flisboac/mixpower-path-mini-bq25672-lv-board/kicad/projects/mixpower-path-mini-bq25672-lv-board-r1/plot/mixpower-path-mini-bq25672-lv-board-r1.pdf

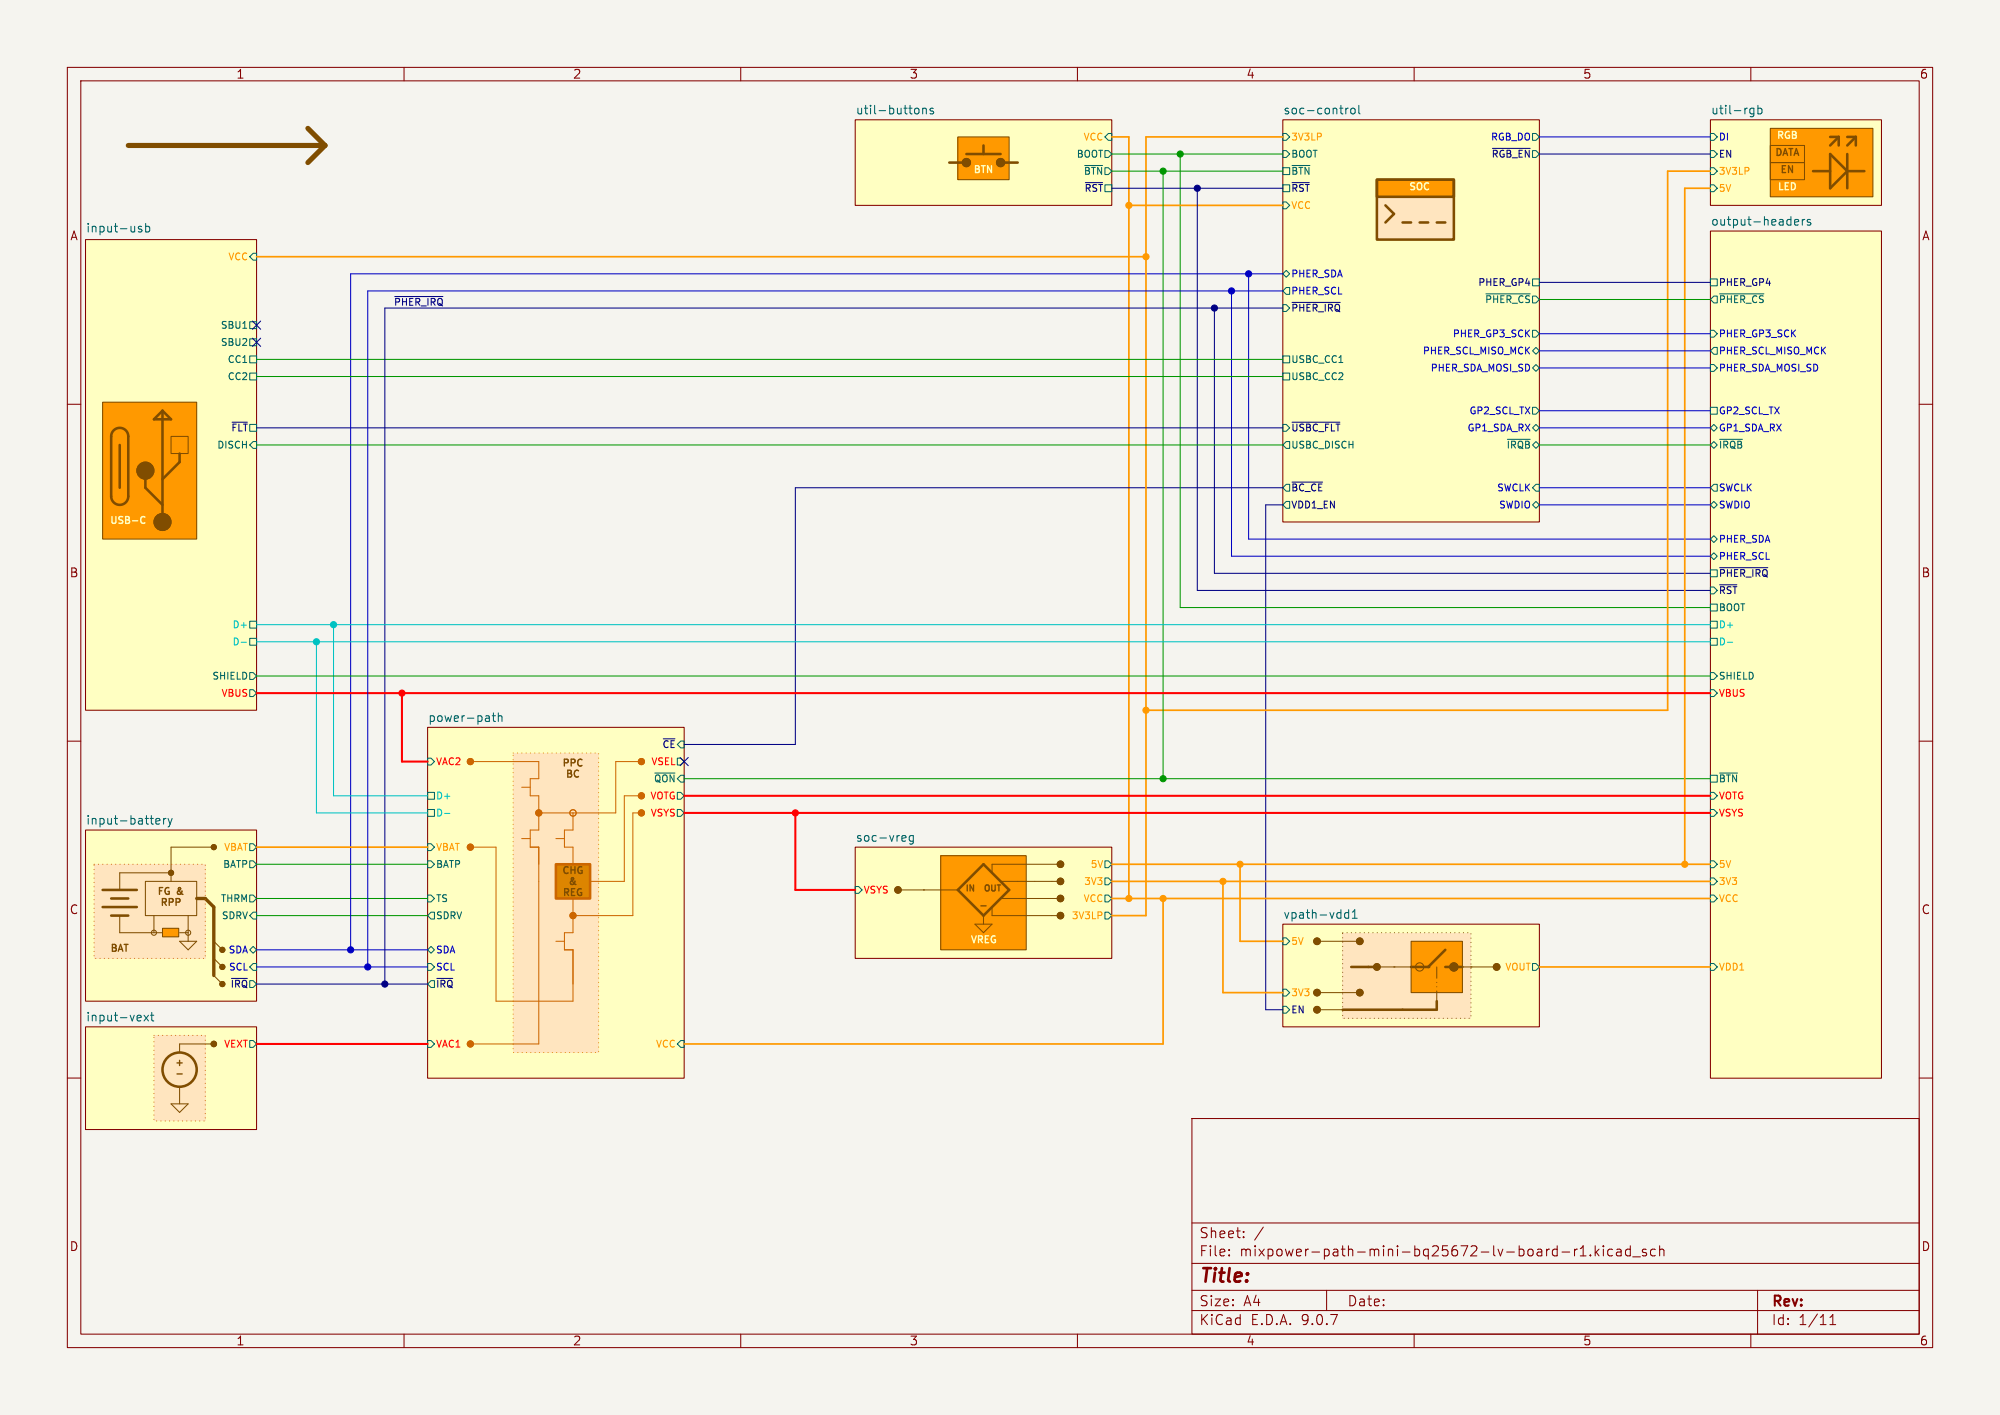
[picture p14: page 1]

~{RST} BOOT util-buttons

Id: 1/11 Title: File: mixpower-path-mini-bq25672-lv-board-r1.kicad_sch Sheet: /

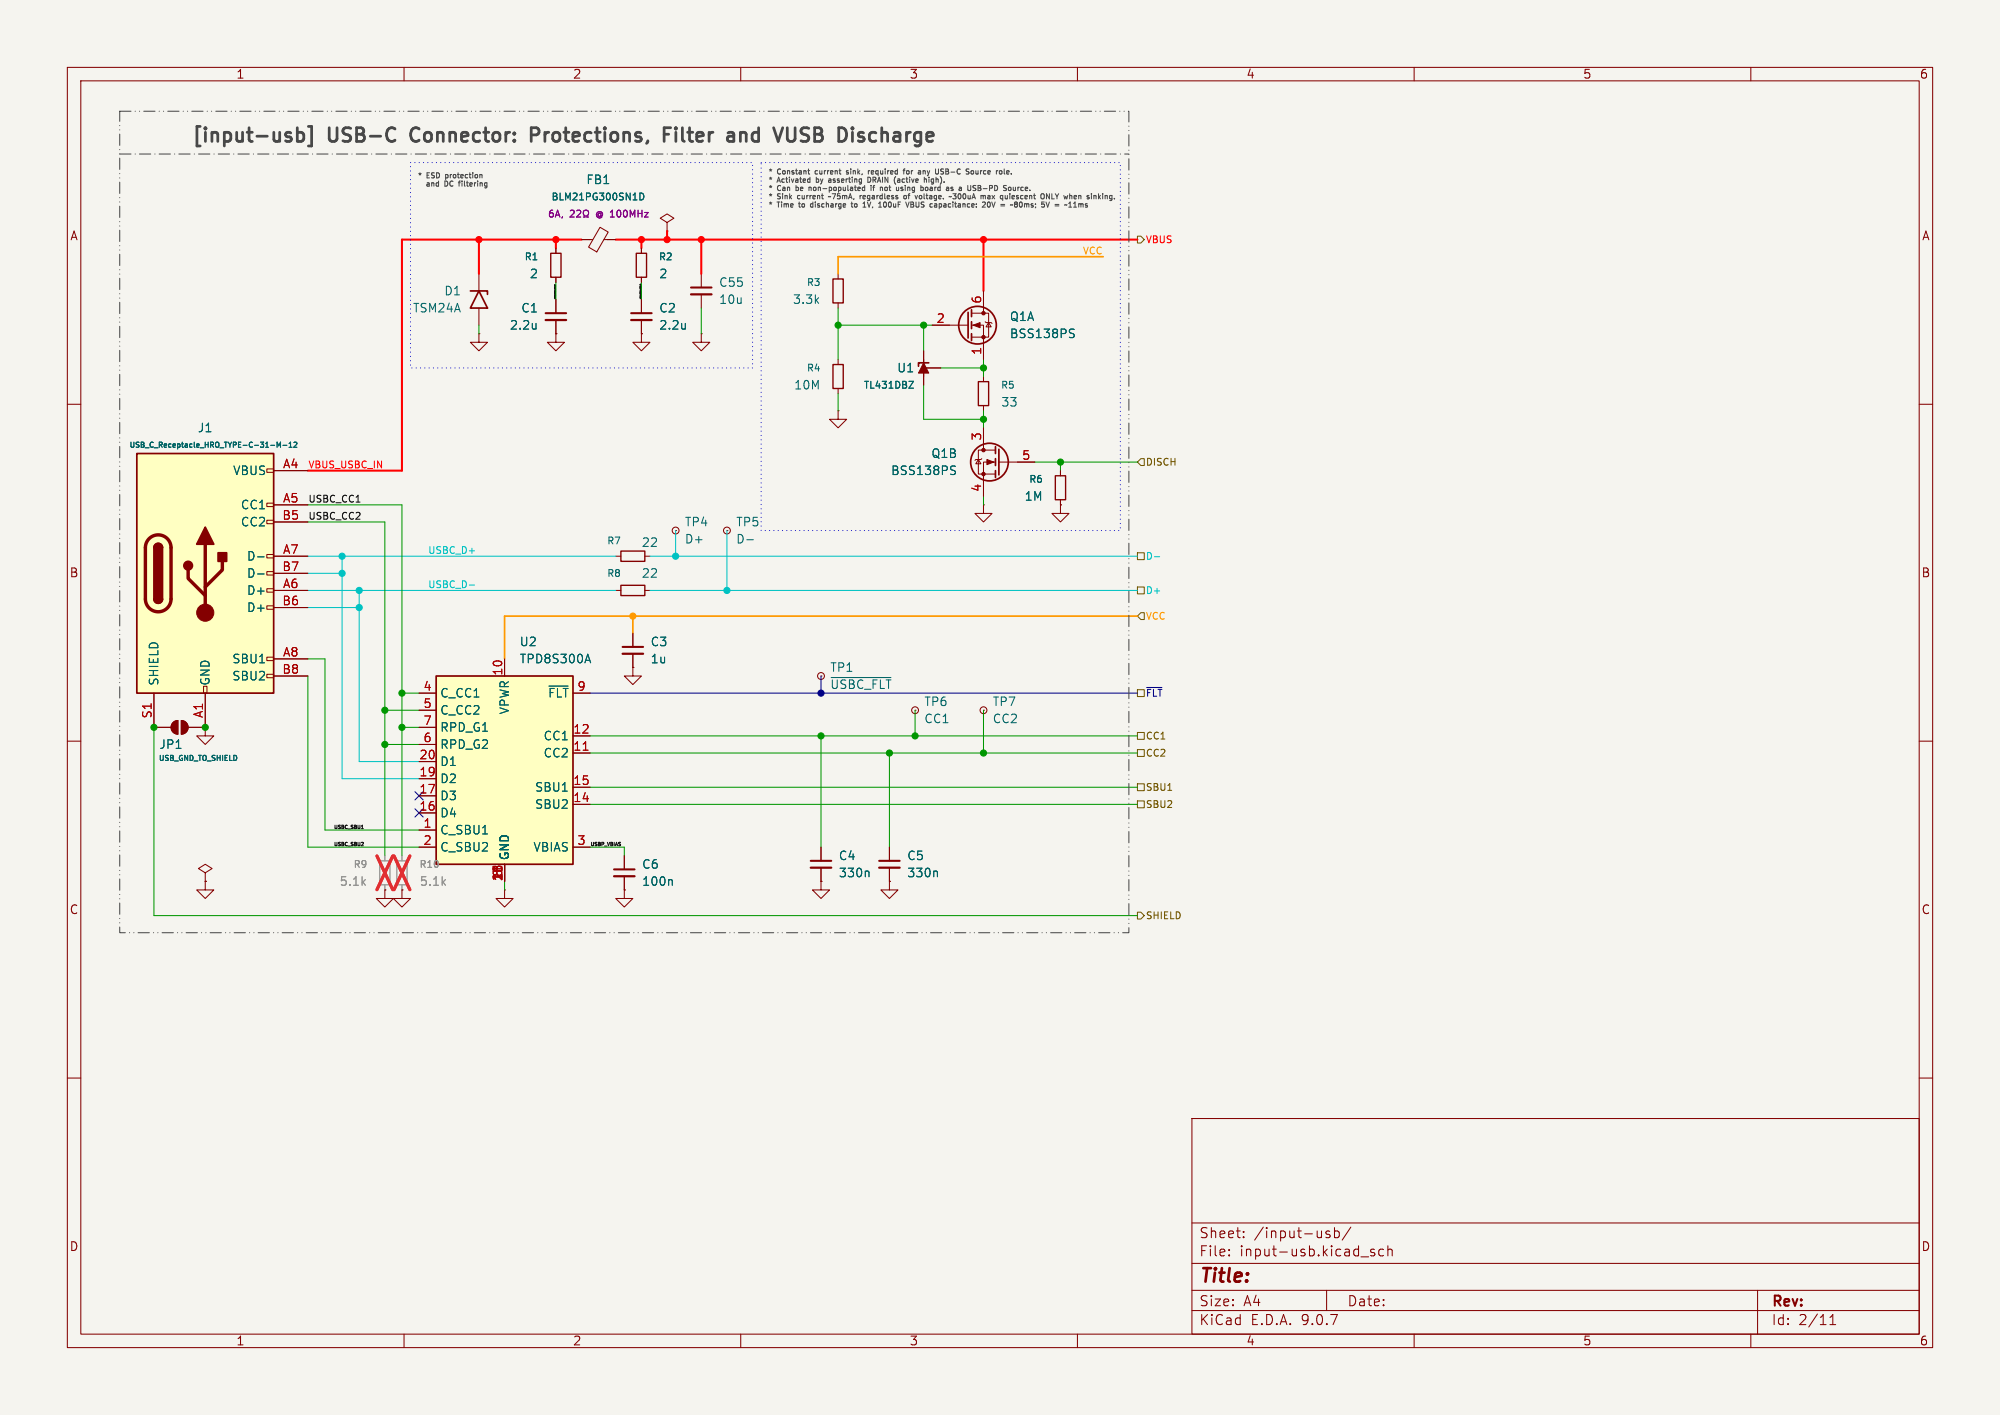
[picture p15: page 2]

Id: 2/11 Title: File: input-usb.kicad_sch Sheet: /input-usb/

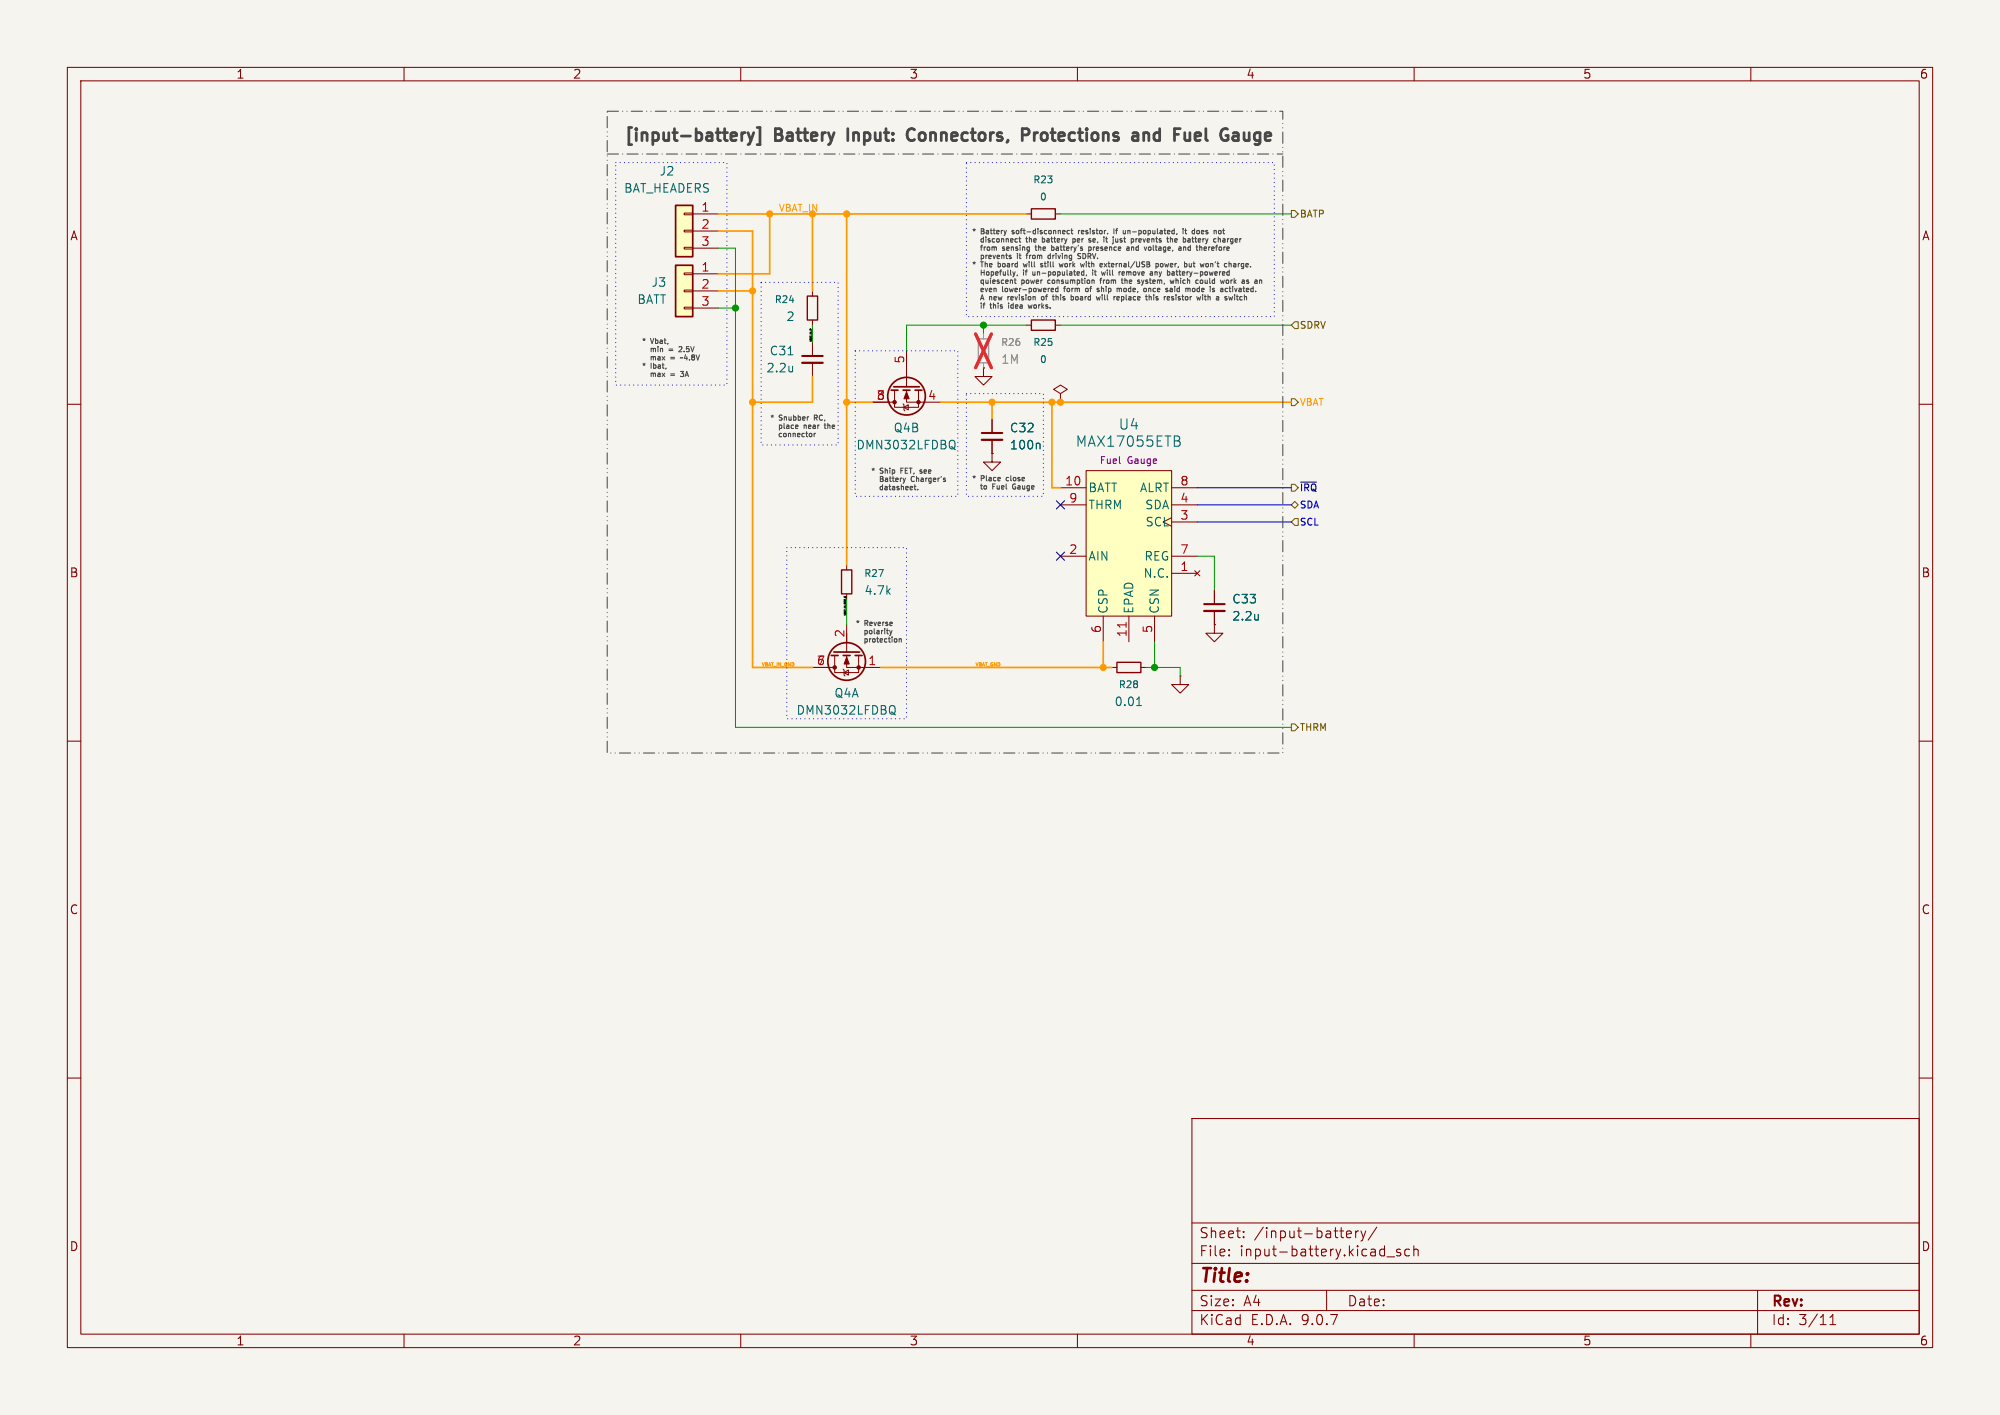
[picture p16: page 3]

* Snubber RC, place near the

5 ALRT 8 SDA 4 SCL 3 REG 7 N.C. 1 U4 MAX17055ETB

Id: 3/11 Title: File: input-battery.kicad_sch Sheet: /input-battery/

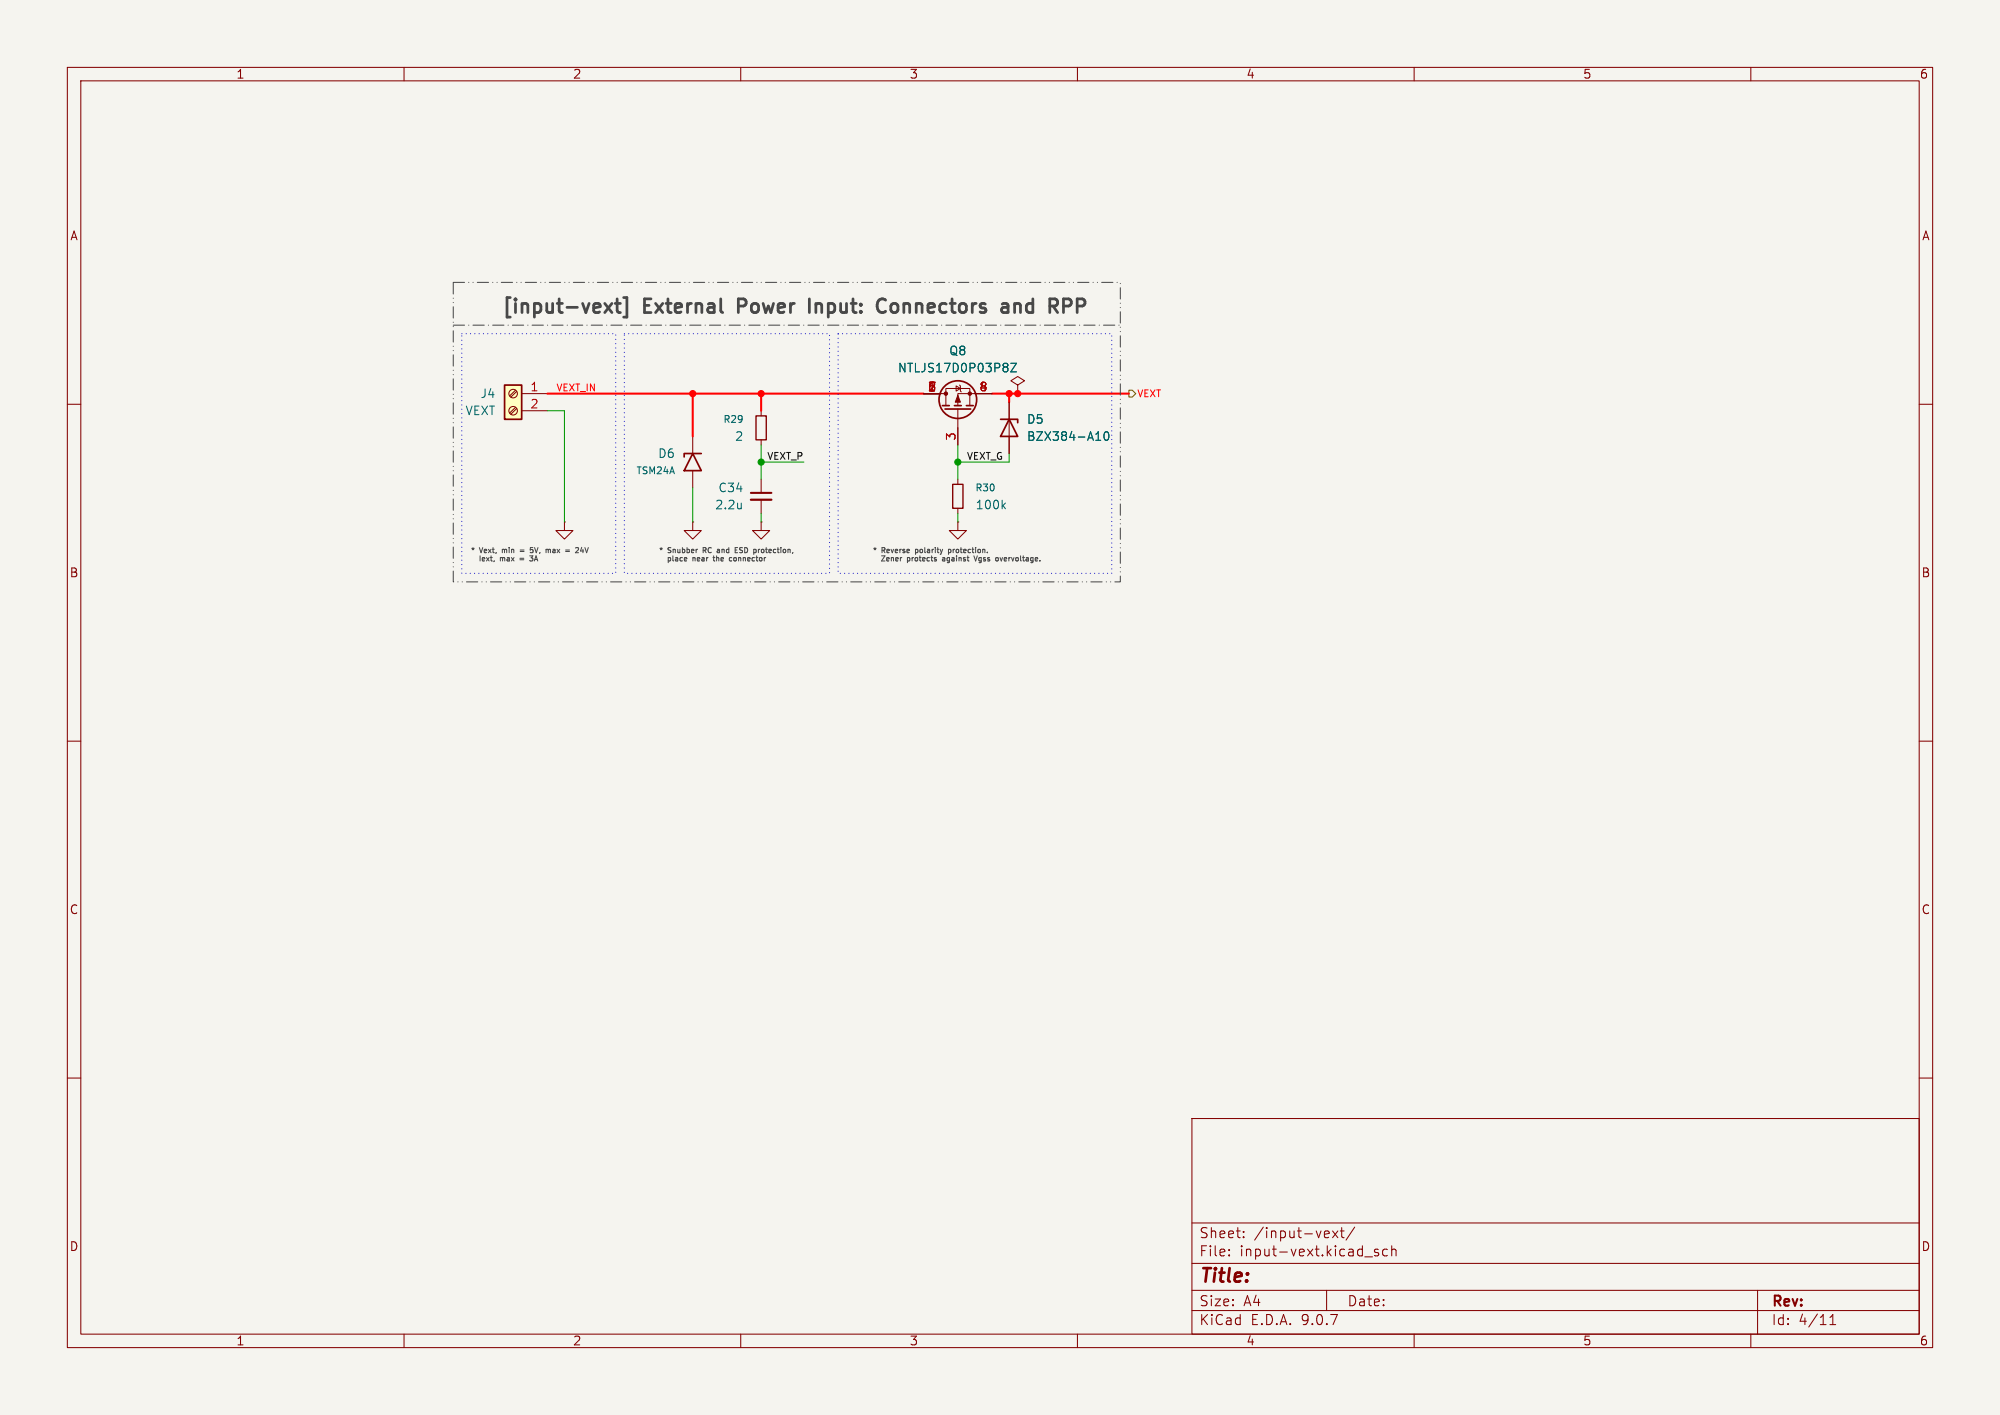
[picture p17: page 4]

* Snubber RC and ESD protection, place near the connector * Vext, min = 5V, max = 24V
Iext, max = 3A

Id: 4/11 Title: File: input-vext.kicad_sch Sheet: /input-vext/

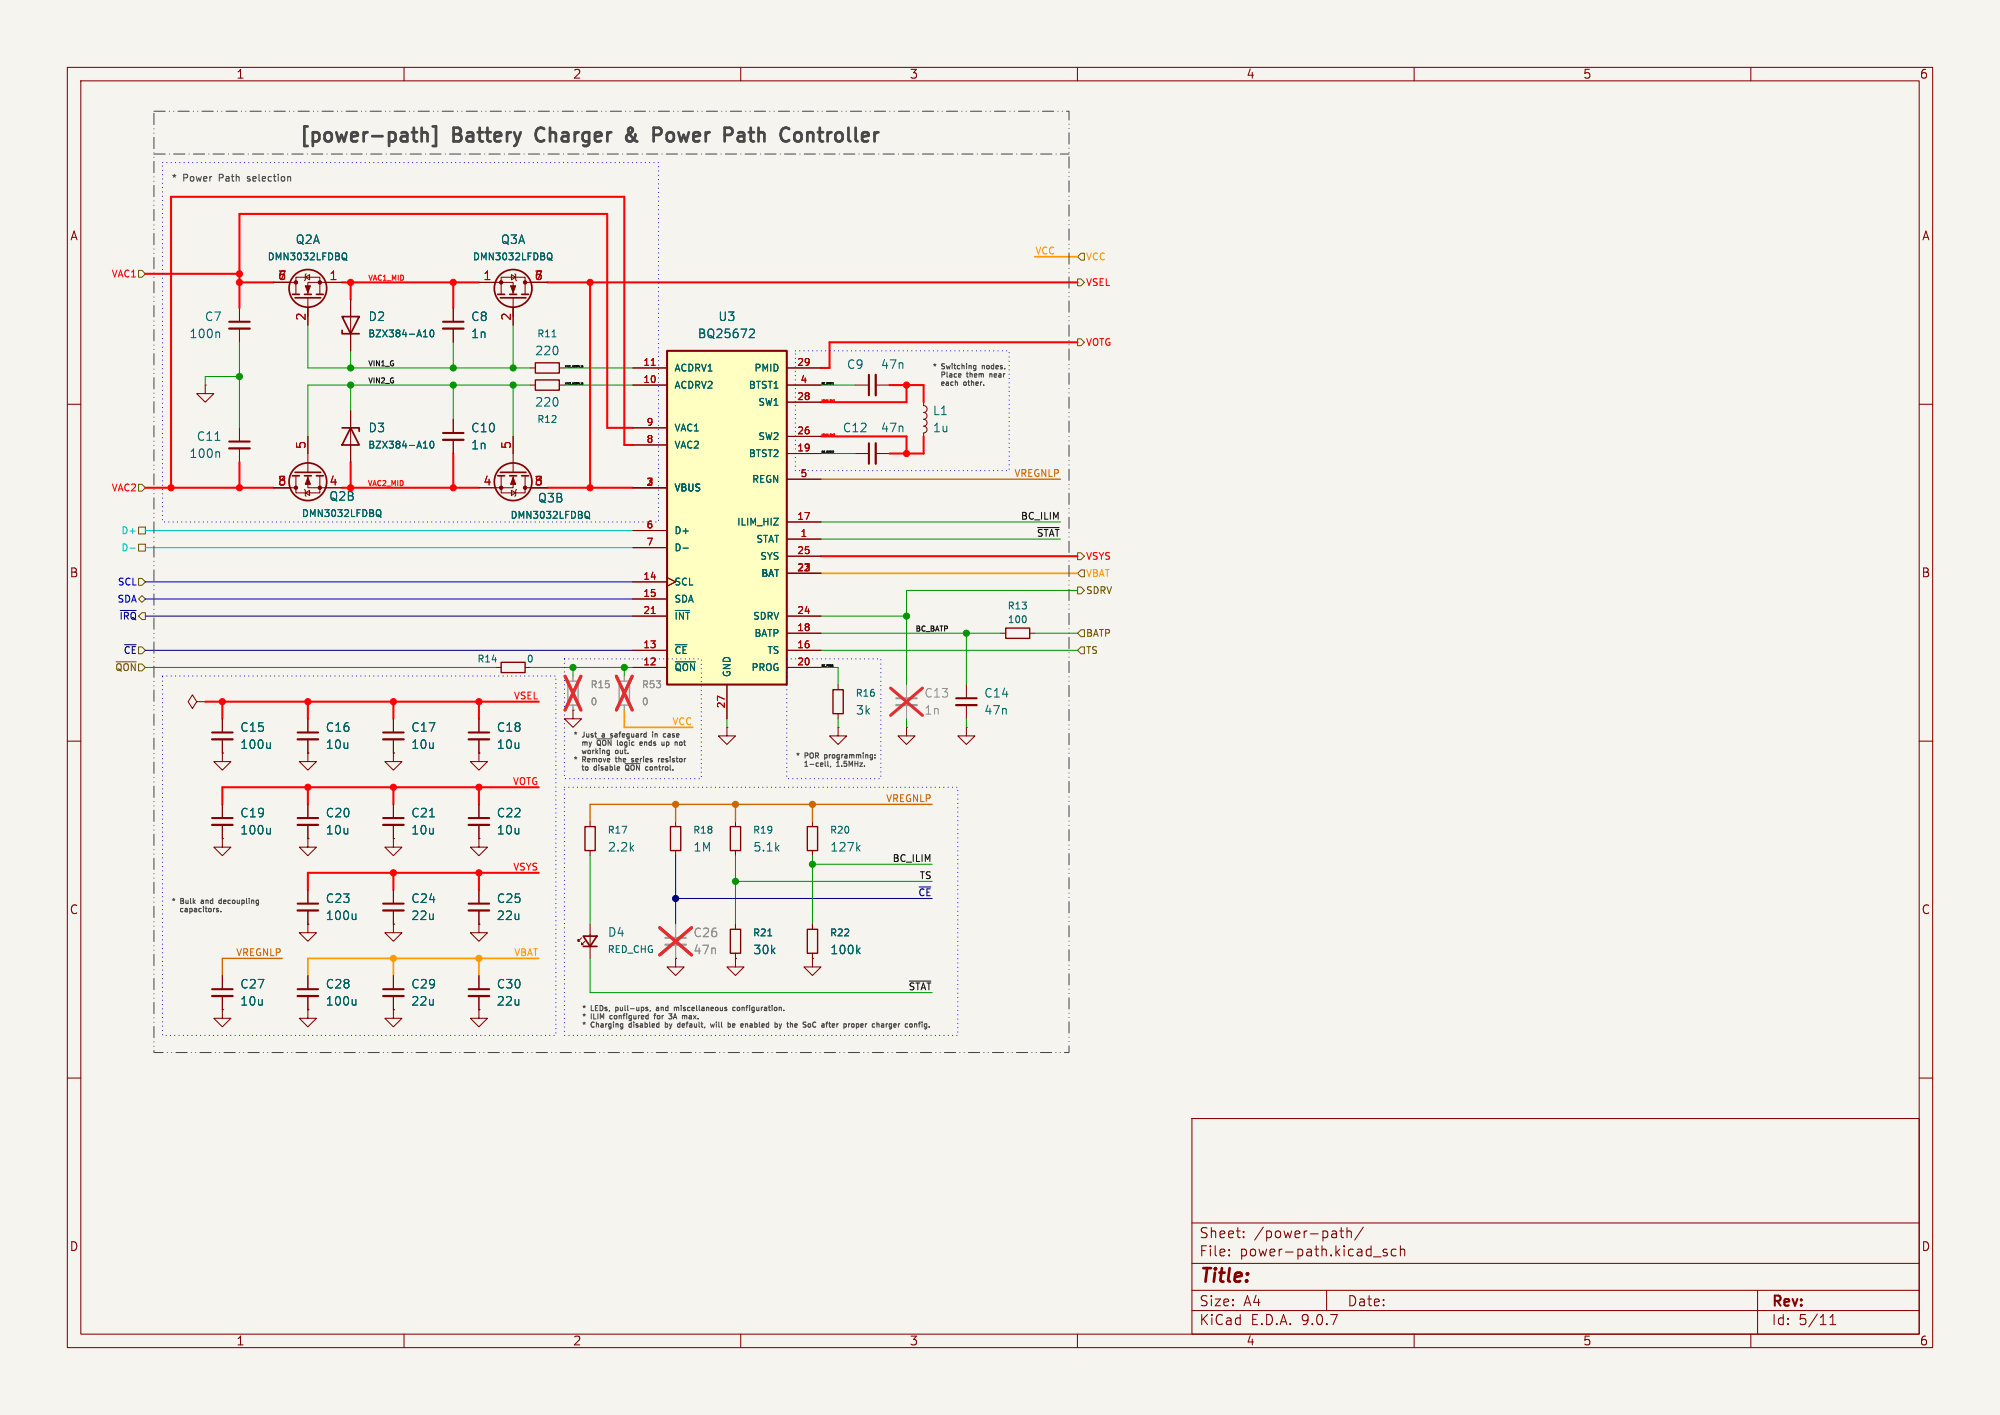
[picture p18: page 5]

Id: 5/11 Title: File: power-path.kicad_sch Sheet: /power-path/ C15

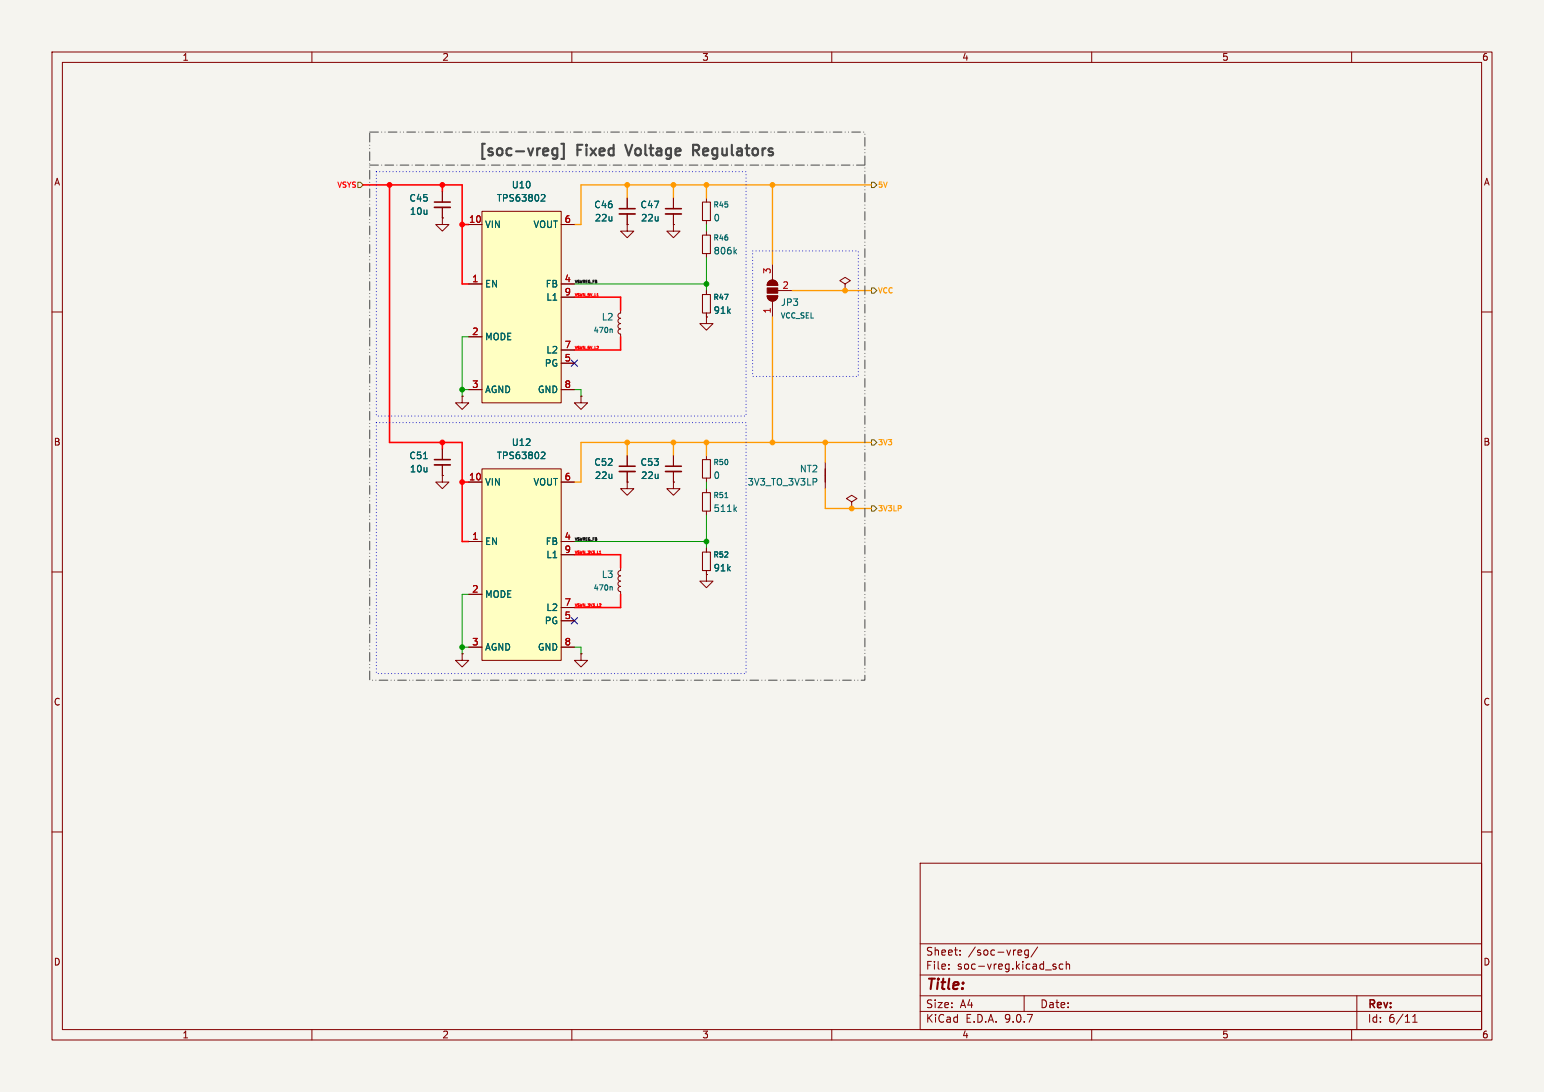
[picture p19: page 6]

Id: 6/11 Title: File: soc-vreg.kicad_sch Sheet: /soc-vreg/

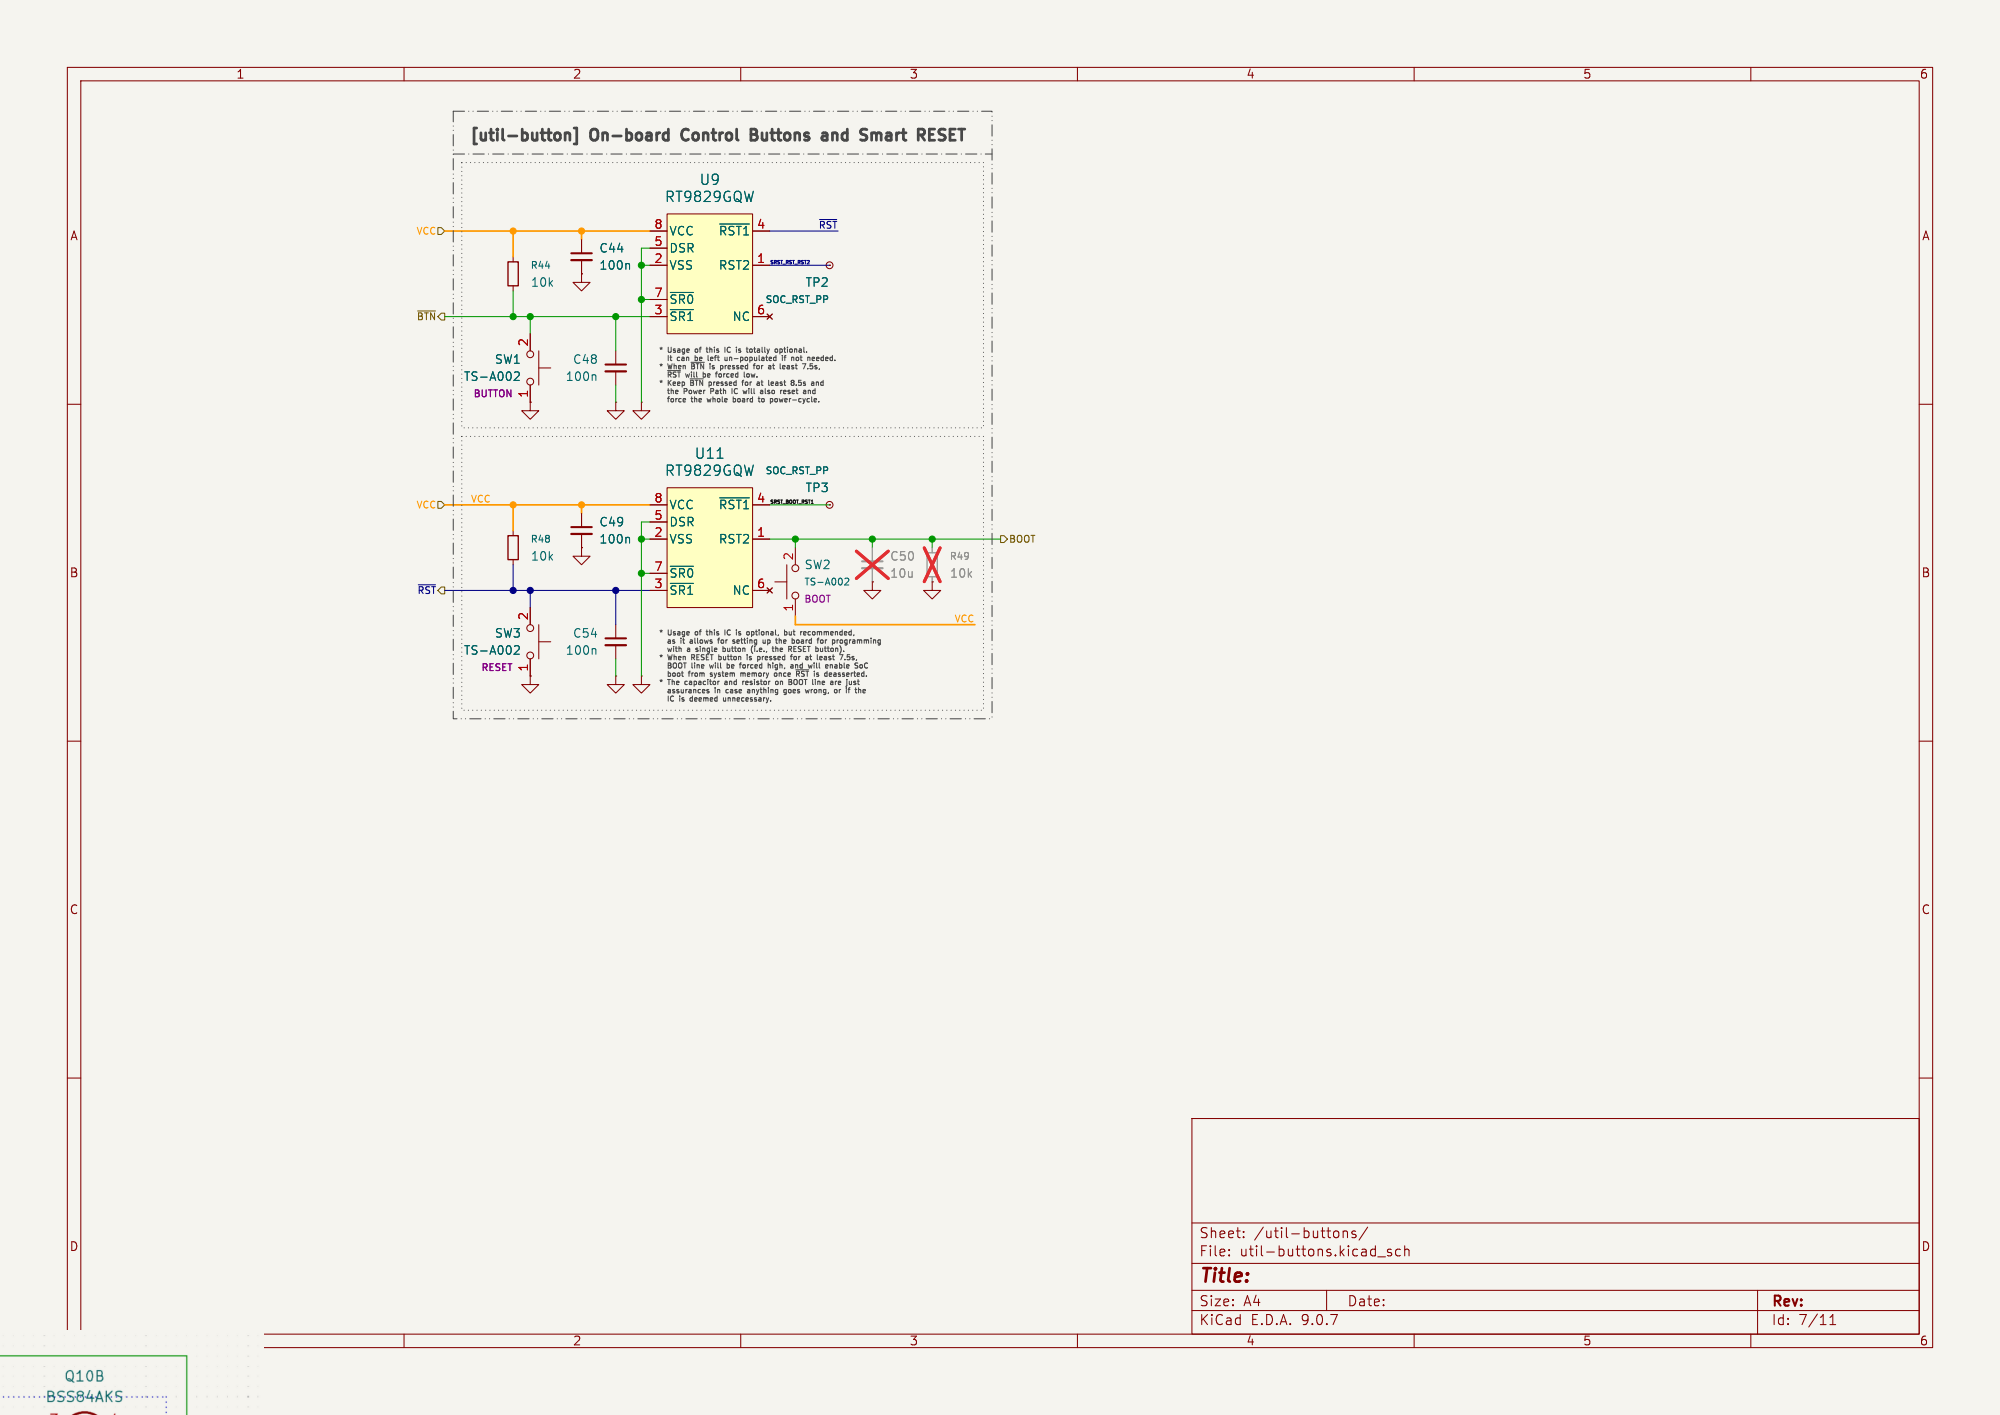
[picture p20: page 7]

IC is deemed unnecessary. U9 RT9829GQW
SRST_BOOT_RST1 ~{RST}

the Power Path IC will also reset and

Id: 7/11 Title: File: util-buttons.kicad_sch Sheet: /util-buttons/

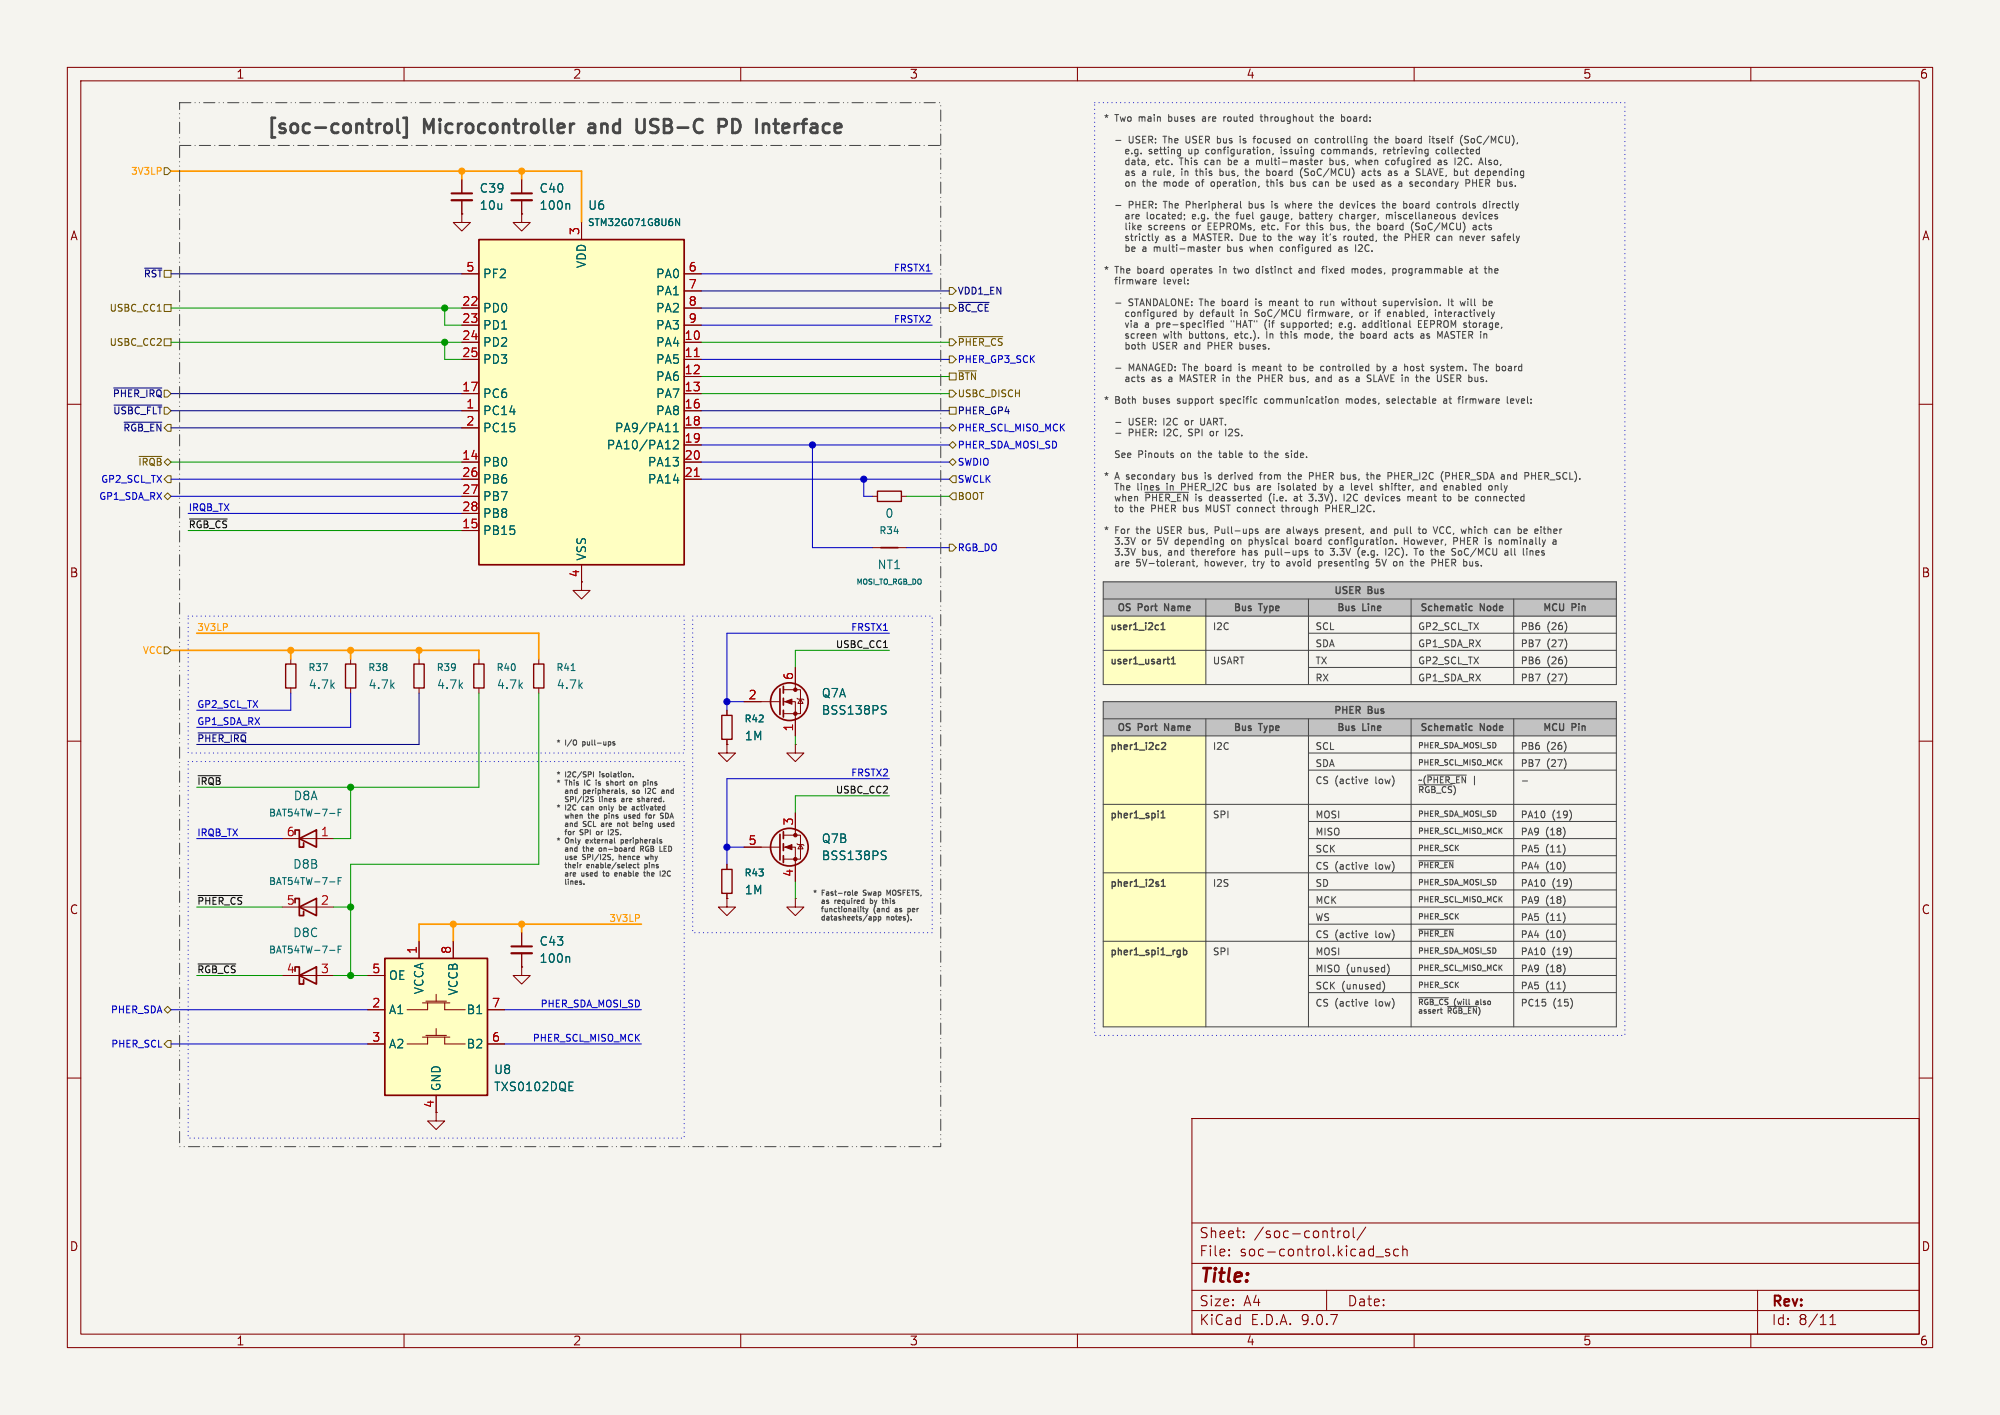
[picture p21: page 8]

and SCL are not being used
BSS138PS C43

Id: 8/11 Title: File: soc-control.kicad_sch Sheet: /soc-control/ 5

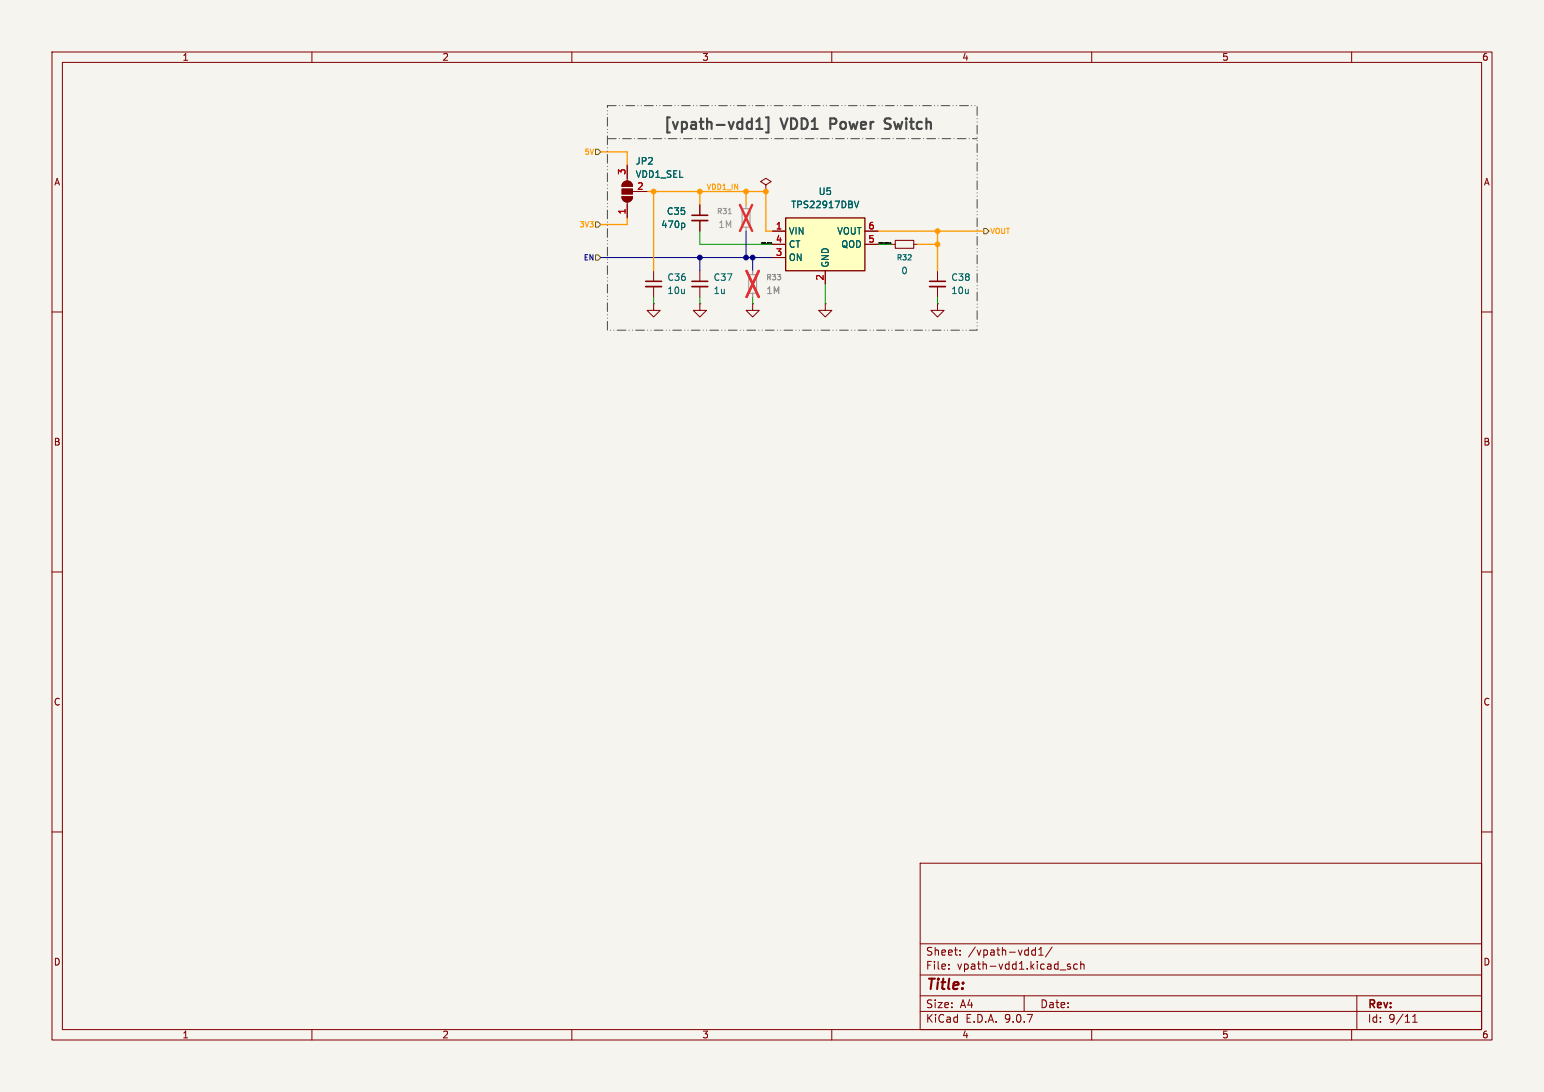
[picture p22: page 9]

Id: 9/11 Title: File: vpath-vdd1.kicad_sch Sheet: /vpath-vdd1/

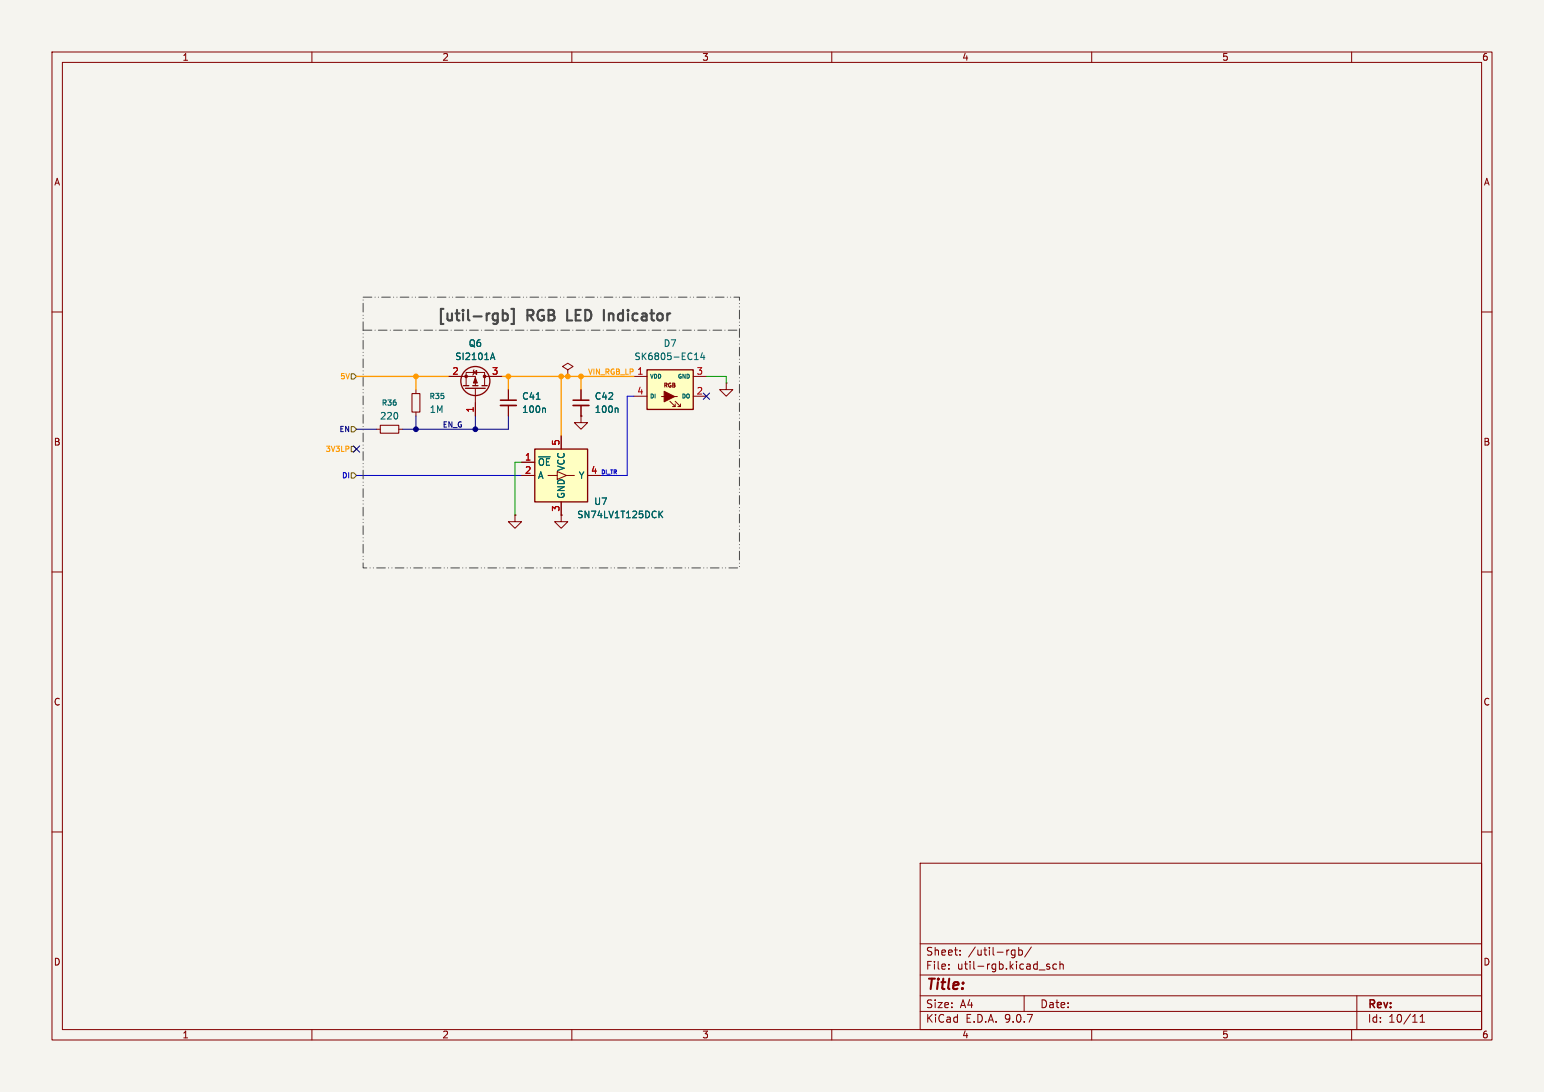
[picture p23: page 10]

Id: 10/11 Title: File: util-rgb.kicad_sch Sheet: /util-rgb/

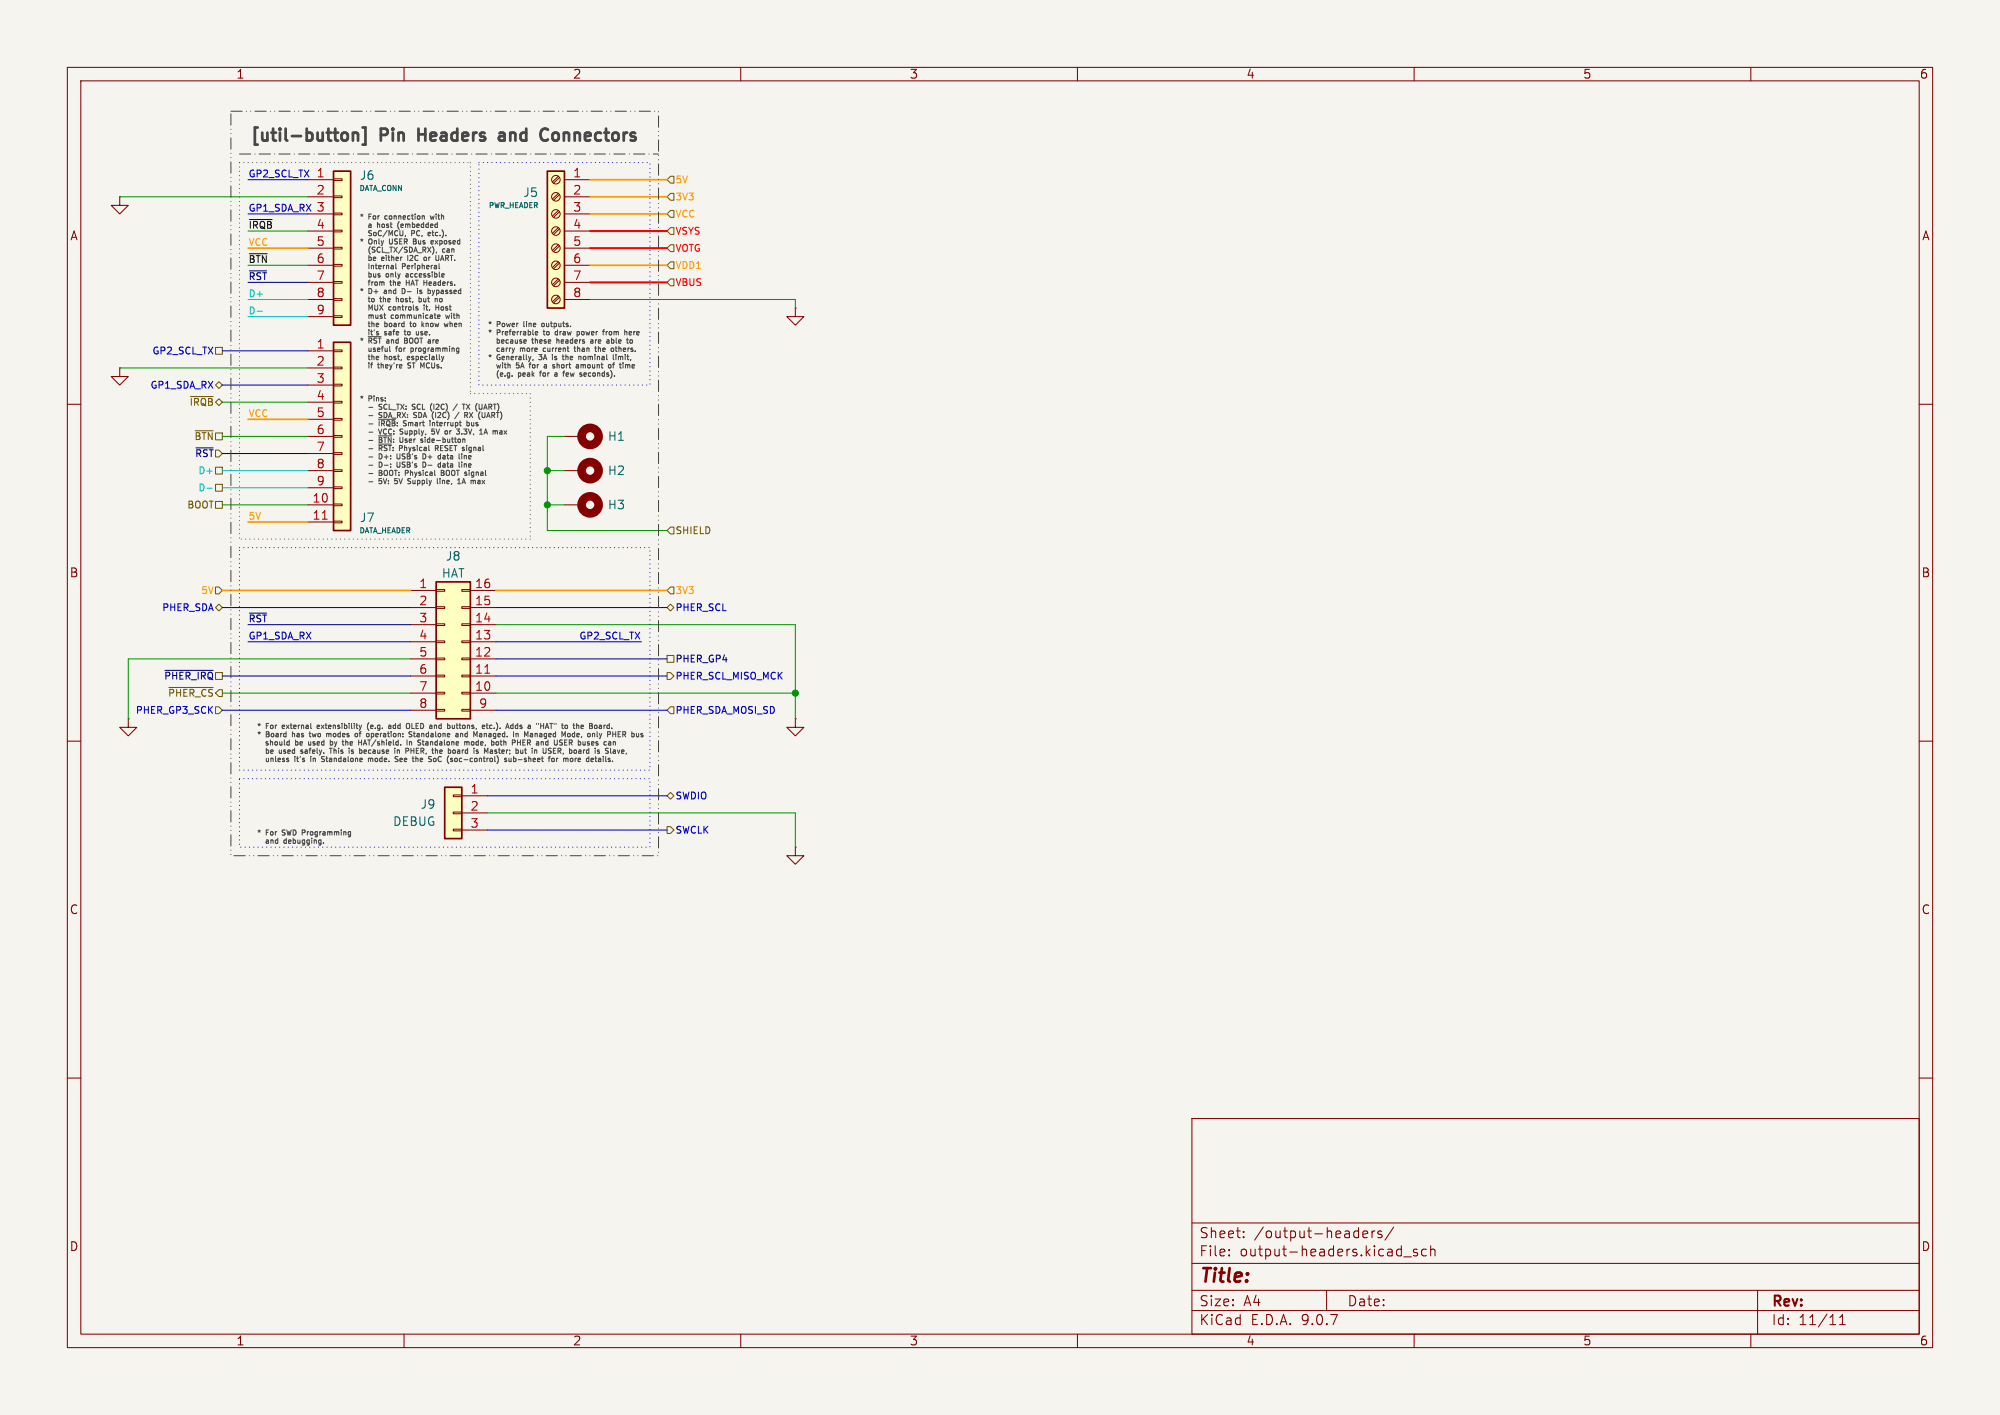
[picture p24: page 11]

DATA_HEADER 123456789
~{BTN} ~{RST} D- GP1_SDA_RX D+* For SWD Programming
J9 DEBUG 123456789
~{IRQB} ~{BTN} ~{RST} PHER_SDA D+D- GP2_SCL_TX GP1_SDA_RX

from the HAT Headers. * D+ and D- is bypassed

the board to know when
it's safe to use. * ~{RST}and BOOT are

Id: 11/11 Title: File: output-headers.kicad_sch Sheet: /output-headers/ 12345678
