flisboac/mixpower-path-mini-bq25672-lv-board/kicad/projects/mixpower-path-mini-bq25672-lv-board-r1/mixpower-path-mini-bq25672-lv-board-r1.kicad_pcb

## KiCad design kicad/projects/mixpower-path-mini-bq25672-lv-board-r1/mixpower-path-mini-bq25672-lv-board-r1.kicad_pcb (2026-04-27)

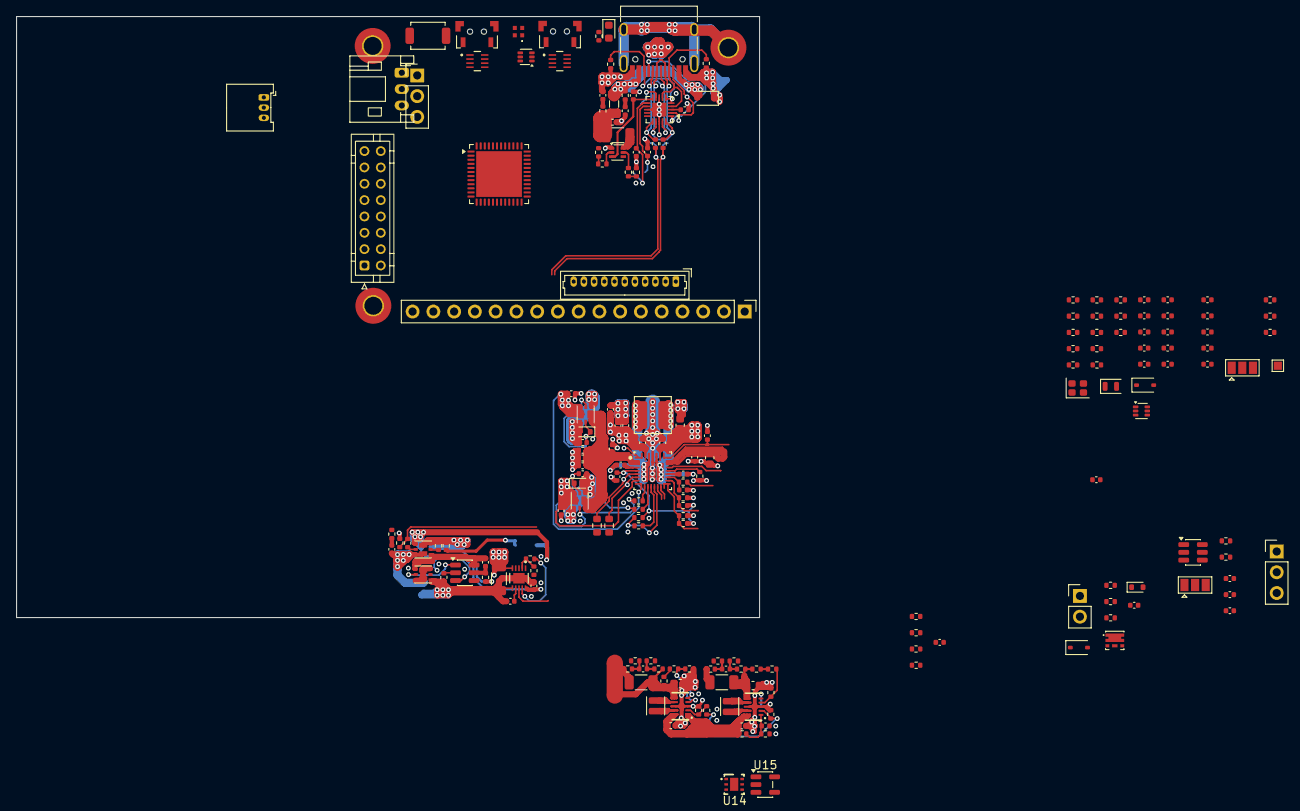
[picture p25: board mixpower-path-mini-bq25672-lv-board-r1.kicad_pcb from above]

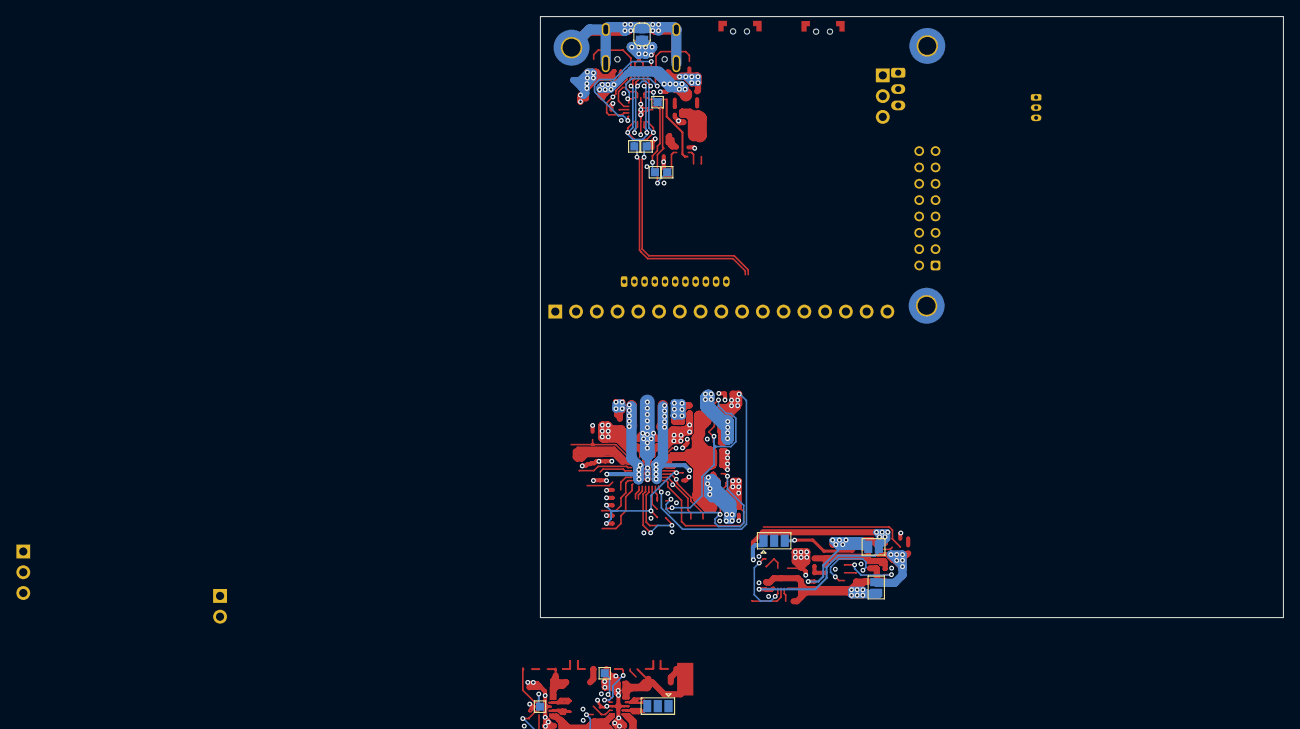
[picture p26: board mixpower-path-mini-bq25672-lv-board-r1.kicad_pcb from below]

Board: 4 copper layers, 90.9 x 73.6 mm, 205 parts (12 on the bottom side), 141 nets.

Parts:
C1: 1u; C_0402_1005Metric
C2: 10n; C_0402_1005Metric
C3, C4, C9, C10, C17, C18, C41, C42, C43, C44, C45, C46, C48, C49, C50, C61: 100n; C_0402_1005Metric
C5, C13, C16, C19, C20, C23, C24, C29, C30, C36, C37, C47, C51, C52, C53, C58, C60: 10u; C_0402_1005Metric
C6, C7: 330n; C_0402_1005Metric
C8, C11: 2.2u; C_0402_1005Metric
C12: 2.2u; R_0402_1005Metric
C14, C15, C21, C22: 100u; C_0402_1005Metric
C25, C26, C39, C40: 47u; C_0603_1608Metric
C27, C28, C34, C38: 1n; C_0402_1005Metric
C31, C32, C33, C35: 47n; C_0402_1005Metric
C54, C55: 7p; C_0402_1005Metric
C56, C57: 10p; C_0402_1005Metric
C59: 470p; C_0402_1005Metric
D1, D2: PESD24VV1BA; D_SOD-323
D3, D4, D5: BZX584C18; D_SOD-523
D6: RED_CHG; LED_0603_1608Metric
D7: 1N5817WS; D_SOD-323
D8: SK6805-EC14
FB1: BLM21PG300SN1D; L_0805_2012Metric
H1, H2, H3: M1; MountingHole_2.2mm_M2_Pad_TopBottom
J1: USB_C_Receptacle_HRO_TYPE-C-31-M-12
J2: BAT_HEADERS; PinHeader_1x03_P2.54mm_Vertical
J3: BATT_JST; JST_PH_S3B-PH-K_1x03_P2.00mm_Horizontal
J4: BATT_PB; Molex_PicoBlade_53048-0310_1x03_P1.25mm_Horizontal
J5: VEXT; PinHeader_1x02_P2.54mm_Vertical
J6: DATA_CONN; Molex_PicoBlade_53047-1110_1x11_P1.25mm_Vertical
J7: DATA_HEADER; PinHeader_1x17_P2.54mm_Vertical
J8: HAT; JST_PHD_B16B-PHDSS_2x08_P2.00mm_Vertical
J9: DEBUG; PinHeader_1x03_P2.54mm_Vertical
JP1: USB_GND_TO_SHIELD; SolderJumper-2_P1.3mm_Open_RoundedPad1.0x1.5mm
JP2, JP4: RTC; SolderJumper-3_P1.3mm_Open_Pad1.0x1.5mm
JP3: VCC_SEL; SolderJumper-3_P1.3mm_Open_Pad1.0x1.5mm
JP5: VDD1_SEL; SolderJumper-3_P1.3mm_Open_Pad1.0x1.5mm
JP9: SHIPFET_DIS; SolderJumper-2_P1.3mm_Open_Pad1.0x1.5mm
JP10: BPROT_DIS; SolderJumper-2_P1.3mm_Open_Pad1.0x1.5mm
L1: 1u; L_Coilcraft_XAL4020-XXX
L2, L3: 470n; L_Changjiang_FTC201612S
NT1: 3V3_TO_3V3LP; NetTie-2_SMD_Pad2.0mm
Q1, Q8: DMG1029SVQ; SOT-563
Q2, Q3, Q5, Q6: DMN3032LFDBQ; Diodes-Incorporated_U-DFN2020-6_Type-B
Q4: NTLJS17D0P03P8Z; vendor-onsemi-483av
Q7: Si1026X; SOT-563
R1, R2, R31: 5.1k; R_0402_1005Metric
R3, R4: 27; R_0402_1005Metric
R5, R6, R12, R22: 2; R_0402_1005Metric
R7, R10, R17, R27, R28: 220; R_0402_1005Metric
R8, R11, R20, R30, R77: 1M; R_0402_1005Metric
R9: 1.8k; R_1206_3216Metric
R13, R23, R34, R50, R51, R52, R53, R54, R55, R56, R57: 100k; R_0402_1005Metric
R14, R36: 100; R_0402_1005Metric
R15, R60, R76, R79: 1k; R_0402_1005Metric
R16, R19, R26, R37, R38, R41, R42, R45, R68, R69, R70, R71, R72, R73, R75: 0; R_0402_1005Metric
R18, R58, R59: 10k; R_0402_1005Metric
R21, R48, R49: 0.01; R_1206_3216Metric
R24, R25: 0; R_0603_1608Metric
R29: 2.2k; R_0402_1005Metric
R32: 30k; R_0402_1005Metric
R33: 127k; R_0402_1005Metric
R35: 3k; R_0402_1005Metric
R39, R40, R61, R64, R74: 10M; R_0402_1005Metric
R43: 806k; R_0402_1005Metric
R44, R47: 91k; R_0402_1005Metric
R46: 511k; R_0402_1005Metric
R62, R63, R65, R66, R67, R78: 4.7k; R_0402_1005Metric
SW1, SW3: TS-A002
SW2: TS-A002; SW_SPST_TS-1088-xR020
TP1: D+; TestPoint_Pad_1.0x1.0mm
TP2: D-; TestPoint_Pad_1.0x1.0mm
TP3: CC1; TestPoint_Pad_1.0x1.0mm
TP4: CC2; TestPoint_Pad_1.0x1.0mm
TP5: ~{USBC_FLT}; TestPoint_Pad_1.0x1.0mm
TP6: SOC_RST_PP; TestPoint_Pad_1.0x1.0mm
TP7: ~{5V_PG}; TestPoint_Pad_1.0x1.0mm
TP8: ~{3V3_PG}; TestPoint_Pad_1.0x1.0mm
U1: TPD8S300A; vendor-ti-RUK0020B
U2: FS312F-G; SOT-23-6
U3: MAX17055ETB; SPECIFIC_MAX17055ETB_21-100013A_T102A2&plus_1C_MXM
U4: BQ25672; vendor-ti-RQM0029A-MFG
U5, U6: TPS63802; vendor-ti-DLA0010A
U7, U8: RT9829GQW; Specific_DFN8_RT9829_RIT
U9: STM32G0B1CEU6; QFN-48-1EP_7x7mm_P0.5mm_EP5.6x5.6mm
U10: TPS22917DBV; SOT-23-6
U14: TPS7A2601; vendor-ti-DRV0006A-NoThermalVias
U15: RT9080-33GJ5; TSOT-23-5
Y1: X201232768KJD2SI; Crystal_SMD_2012-2Pin_2.0x1.2mm
Y2: X201624MKB4SI; Crystal_SMD_2016-4Pin_2.0x1.6mm

Connections:
/input-battery/BATP: JP2.3 (B), R16.1, R36.1
/input-battery/BPROT_CS: R15.1, U2.2 (CS)
/input-battery/BPROT_OC: Q3.5 (G2), U2.3 (OC)
/input-battery/BPROT_OD: Q3.2 (G1), U2.1 (OD)
/input-battery/BPROT_VCC: C9.1, R14.2, U2.5 (VCC)
/input-battery/FG_AIN: R18.2, R19.1, U3.2 (AIN)
/input-battery/FG_REG: C11.1, U3.7 (REG)
/input-battery/FG_THRM: R18.1, U3.9 (THRM)
/input-battery/SDRV: C34.1, R17.1, R20.1, U4.24 (SDRV)
/input-battery/SHIPFET_G: Q2.5 (G2), R17.2
/input-battery/VBAT_GND: C10.2, C11.2, JP10.2 (B), Q3.4 (S2), R15.2, R21.1, U3.6 (CSP), U3.11 (EPAD)
/input-battery/VBAT_GND_MID: Q3.3 (D2), Q3.6 (D1), Q3.7 (D1), Q3.8 (D2)
/input-battery/VBAT_GND_RPP: C9.2, Q2.1 (S1), Q3.1 (S1), U2.6 (GND)
/input-battery/VBAT_IN: J2.1, J3.1, J4.1, JP9.1 (A), Q2.3 (D2), Q2.8 (D2), R12.1, R13.1, R14.1, R16.2
/input-battery/VBAT_IN_GND: C8.2, J2.2, J3.2, J4.2, JP10.1 (A), Q2.6 (D1), Q2.7 (D1)
/input-battery/VBAT_IN_P: C8.1, R12.2
/input-battery/VBAT_IN_RPP_G: Q2.2 (G1), R13.2
/input-battery/~IRQ: J8.8, U3.8 (ALRT), U4.21 (~INT), U9.1 (PC13)
/input-usb/DISCH: R10.2, R11.1, U9.25 (PB13)
/input-usb/DISCH_DRAIN: Q1.6 (D1), R9.2
/input-usb/DISCH_G: Q1.2 (G1), R10.1
/input-usb/SHIELD: H1.1 (1_1), H2.1 (1_1), H3.1 (1_1), J1.S1 (SHIELD), JP1.2 (B)
/input-usb/USBC_CC1: J1.A5 (CC1), R2.1, U1.4 (C_CC1), U1.7 (RPD_G1)
/input-usb/USBC_CC2: J1.B5 (CC2), R1.1, U1.5 (C_CC2), U1.6 (RPD_G2)
/input-usb/USBC_D+: J1.A6 (D+), J1.B6 (D+), R4.1, U1.16 (D4), U1.19 (D2)
/input-usb/USBC_D-: J1.A7 (D-), J1.B7 (D-), R3.1, U1.17 (D3), U1.20 (D1)
/input-usb/USBC_SBU1: J1.A8 (SBU1), U1.1 (C_SBU1)
/input-usb/USBC_SBU2: J1.B8 (SBU2), U1.2 (C_SBU2)
/input-usb/USBC_TPS_VCC: C1.1, Q1.3 (D2), U1.10 (VPWR)
/input-usb/USBP_VBIAS: C3.1, U1.3 (VBIAS)
/input-usb/VBUS: C5.1, C18.2, FB1.2, J7.13, Q6.6 (D1), Q6.7 (D1), R6.1, R9.1, U4.8 (VAC2)
/input-usb/VBUS_USBC_IN: D1.2 (A2), FB1.1, J1.A4 (VBUS), J1.A9 (VBUS), J1.B4 (VBUS), J1.B9 (VBUS), R5.1
/input-usb/VBUS_USBC_IN_POST_P: C4.1, R6.2
/input-usb/VBUS_USBC_IN_PRE_P: C2.1, R5.2
/input-usb/VCC_DIS: R7.1, R8.1, U9.24 (PB12)
/input-usb/~FLT: TP5.1 (1_1), U1.9 (~FLT), U9.31 (PC7)
/input-vext/VEXT: C13.1, C17.1, D3.1 (K), Q4.4 (S), Q4.8 (S), Q5.6 (D1), Q5.7 (D1), U4.9 (VAC1)
/input-vext/VEXT_FLT_P: C12.1, R22.2
/input-vext/VEXT_G: D3.2 (A), Q4.3 (G), R23.1
/input-vext/VEXT_IN: D2.2 (A2), J5.1, Q4.1 (D), Q4.2 (D), Q4.5 (D), Q4.6 (D), Q4.7 (D), R22.1
/output-headers/3V3: J6.5, J7.5, J8.16, JP3.1 (A), JP5.1 (A), R49.2, R52.2
/output-headers/5V: J6.11, J7.11, J8.1, JP3.3 (B), JP5.3 (B), Q8.4 (S2), R48.2, R51.2, R77.1
/output-headers/BOOT: J6.10, J7.10, JP4.2 (C)
/output-headers/D+: J6.8, J7.8, R4.2, R24.2, TP2.1 (1_1), U9.34 (PA10/PA12)
/output-headers/D-: J6.9, J7.9, R3.2, R25.2, TP1.1 (1_1), U9.33 (PA9/PA11)
/output-headers/GP1_IRQ2: J8.12, U9.11 (PA0)
/output-headers/GP2: J8.7, U9.12 (PA1)
/output-headers/GP3: J8.14, U9.15 (PA4)
/output-headers/GP4: J8.5, U9.16 (PA5)
/output-headers/PHER2_MISO_SDA: J8.9, U9.43 (PB4)
/output-headers/PHER2_SCK: J8.6, U9.42 (PB3)
/output-headers/SWDIO: J9.1, U9.35 (PA13)
/output-headers/USER1_SCL_TX: J6.1, J7.1, J8.15, R63.2, U9.45 (PB6)
/output-headers/USER1_SDA_RX: J6.3, J7.3, J8.2, R62.2, U9.46 (PB7)
/output-headers/VDD1: C60.1, J7.12, R75.2, U10.6 (VOUT)
/output-headers/~BTN: C45.1, J6.6, J7.6, R26.2, R58.2, SW1.2, U7.3 (~SR1), U9.47 (PB8)
/output-headers/~IRQB: D7.2 (A), J6.4, J7.4, R67.2, U9.14 (PA3)
/output-headers/~RST: C46.1, J6.7, J7.7, J8.3, R59.2, SW2.2, U7.4 (~RST1), U8.3 (~SR1), U9.10 (PF2)
/power-path/BC_BATP: C35.1, R36.2, U4.18 (BATP)
/power-path/BC_BTST1: C32.1, U4.4 (BTST1)
/power-path/BC_BTST2: C33.1, U4.19 (BTST2)
/power-path/BC_D+: R24.1, U4.6 (D+)
/power-path/BC_D-: R25.1, U4.7 (D-)
/power-path/BC_ILIM: R33.1, R34.2, U4.17 (ILIM_HIZ)
/power-path/BC_PROG: R35.2, U4.20 (PROG)
/power-path/TS: J2.3, J3.3, J4.3, R19.2, R31.1, R32.2, U4.16 (TS)
/power-path/VAC1_MID: C27.1, D4.2 (A), Q5.1 (S1), Q5.4 (S2)
/power-path/VAC2_MID: C28.2, D5.2 (A), Q6.1 (S1), Q6.4 (S2)
/power-path/VBAT: C10.1, C22.1, C26.1, J7.16, JP2.1 (A), JP9.2 (B), Q2.4 (S2), U3.10 (BATT), U4.22 (BAT), U4.23 (BAT)
/power-path/VIN1_ACDRV_G: R27.2, U4.11 (ACDRV1)
/power-path/VIN1_G: C27.2, D4.1 (K), Q5.2 (G1), Q5.5 (G2), R27.1
/power-path/VIN2_ACDRV_G: R28.2, U4.10 (ACDRV2)
/power-path/VIN2_G: C28.1, D5.1 (K), Q6.2 (G1), Q6.5 (G2), R28.1
/power-path/VOTG: C15.1, C20.1, C24.1, C30.1, J7.15, U4.29 (PMID)
/power-path/VREGNLP: C16.1, R29.2, R30.2, R31.2, R33.2, U4.5 (REGN)
/power-path/VSEL: C14.1, C19.1, C23.1, C29.1, Q5.3 (D2), Q5.8 (D2), Q6.3 (D2), Q6.8 (D2), U4.2 (VBUS), U4.3 (VBUS)
/power-path/VSWN_SW1: C32.2, L1.1, U4.28 (SW1)
/power-path/VSWN_SW2: C33.2, L1.2, U4.26 (SW2)
/power-path/VSYS: C21.1, C25.1, C36.1, C37.1, J7.14, R39.2, U4.25 (SYS), U5.10 (VIN), U6.1 (EN), U6.10 (VIN)
/power-path/~BC_QON: R26.1, U4.12 (~QON)
/power-path/~CE: C31.1, R30.1, U4.13 (~CE), U9.39 (PD1)
/power-path/~STAT: D6.1 (K), U4.1 (STAT)
/soc-control/3V3LP: C50.1, C53.1, NT1.1, Q1.4 (S2), U9.6 (VDD)
/soc-control/5V_EN: R37.2, U9.41 (PD3)
/soc-control/BOOT: C47.1, JP4.1 (A), R60.2, R72.2, SW3.2
/soc-control/FRSTX1: Q7.2 (G), R61.1, U9.26 (PB14)
/soc-control/FRSTX2: Q7.5 (G), R64.1, U9.30 (PC6)
/soc-control/IRQB_TX: D7.1 (K), U9.13 (PA2)
/soc-control/OSC32_IN: R68.2, U9.2 (PC14)
/soc-control/OSC32_OUT: R69.2, U9.3 (PC15)
/soc-control/OSC_IN: R70.1, U9.8 (PF0)
/soc-control/OSC_OUT: R71.2, U9.9 (PF1)
/soc-control/PHER1_SCL: J8.13, R66.2, U3.3 (SCL), U4.14 (SCL), U9.18 (PA7)
/soc-control/PHER1_SDA: J8.4, R65.2, U3.4 (SDA), U4.15 (SDA), U9.17 (PA6)
/soc-control/PHER2_MOSI_SCL: J8.11, R73.1, U9.44 (PB5)
/soc-control/PHER2_RGB_CS: Q8.2 (G1), R78.1, U9.37 (PA15)
/soc-control/PHER2_RGB_DO: Q8.1 (S1), R73.2, R78.2
/soc-control/SNS_3V3_N: C42.1, R52.1, R56.1, U9.20 (PB1)
/soc-control/SNS_3V3_P: C42.2, R53.1, R57.1, U9.19 (PB0)
/soc-control/SNS_5V_N: C41.2, R51.1, R55.1, U9.22 (PB10)
/soc-control/SNS_5V_P: C41.1, R50.1, R54.1, U9.21 (PB2)
/soc-control/SWCLK: J9.3, R72.1, U9.36 (PA14)
/soc-control/SWREG_MODE: R38.2, R40.2, U5.2 (MODE), U9.40 (PD2)
/soc-control/USBC_CC1: C6.1, Q7.6 (D), TP3.1 (1_1), U1.12 (CC1), U9.28 (PA8), U9.29 (PA9/UCPD1_DBCC1)
/soc-control/USBC_CC2: C7.1, Q7.3 (D), TP4.1 (1_1), U1.11 (CC2), U9.27 (PB15), U9.32 (PA10/UCPD1_DBCC2)
/soc-control/VBAT: C48.1, C51.1, JP2.2 (C), U9.4 (VBAT)
/soc-control/VDD1_EN: R74.1, U9.48 (PB9), U10.3 (ON)
/soc-control/VREF: C49.1, C52.1, U9.5 (VREF+)
/soc-control/~PHER2_RGB_EN: R76.2, U9.38 (PD0)
/soc-vreg/3V3_PRE: C40.1, NT1.2, R45.2, R49.1, R53.2, U6.6 (VOUT)
/soc-vreg/5V_PRE: C39.1, R42.2, R48.1, R50.2, U5.6 (VOUT)
/soc-vreg/VSWN_3V3_L1: L3.1, U6.9 (L1)
/soc-vreg/VSWN_3V3_L2: L3.2, U6.7 (L2)
/soc-vreg/VSWN_5V_L1: L2.1, U5.9 (L1)
/soc-vreg/VSWN_5V_L2: L2.2, U5.7 (L2)
/soc-vreg/VSWREG_3V3_FB: R46.1, R47.2, U6.4 (FB)
/soc-vreg/VSWREG_3V3_MODE: R38.1, R41.2, U6.2 (MODE)
/soc-vreg/VSWREG_3V3_PG: TP8.1 (1_1), U6.5 (PG)
/soc-vreg/VSWREG_5V_EN: C38.1, R37.1, R39.1, U5.1 (EN)
/soc-vreg/VSWREG_5V_FB: R43.1, R44.2, U5.4 (FB)
/soc-vreg/VSWREG_5V_PG: TP7.1 (1_1), U5.5 (PG)
/soc-vreg/~SNS_EN: R54.2, R55.2, R56.2, R57.2, U9.23 (PB11)
/util-buttons/SRST_BOOT_RST1: JP4.3 (B), U8.4 (~RST1)
/util-buttons/SRST_BOOT_RST2: R60.1, U8.1 (RST2)
/util-buttons/SRST_RST_RST2: TP6.1 (1_1), U7.1 (RST2)
/util-buttons/VPULLUP: C43.1, C44.1, JP3.2 (C), R58.1, R59.1, R62.1, R63.1, R65.1, R66.1, R67.1, SW3.1, U7.8 (VCC), U8.8 (VCC)
/util-rgb/EN_G: Q8.5 (G2), R76.1, R77.2
/util-rgb/VIN_RGB_LP: C61.1, D8.1 (VDD), Q8.3 (D2), R79.1
/vpath-vdd1/VDD1_CT_G: C59.2, U10.4 (CT)
/vpath-vdd1/VDD1_IN: C58.1, C59.1, JP5.2 (C), U10.1 (VIN)
/vpath-vdd1/VDD1_QOD_G: R75.1, U10.5 (QOD)
GND: C1.2, C2.2, C3.2, C4.2, C5.2, C6.2, C7.2, C12.2, C13.2, C14.2, C15.2, C16.2, C17.2, C18.1, C19.2, C20.2, C21.2, C22.2, C23.2, C24.2, C25.2, C26.2, C29.2, C30.2, C31.2, C34.2, C35.2, C36.2, C37.2, C38.2, C39.2, C40.2, C43.2, C44.2, C45.2, C46.2, C47.2, C48.2, C49.2, C50.2, C51.2, C52.2, C53.2, C54.1, C55.2, C56.1, C57.2, C58.2, C60.2, C61.2, D1.1 (A1), D2.1 (A1), D8.3 (GND), J1.A1 (GND), J1.A12 (GND), J1.B1 (GND), J1.B12 (GND), J5.2, J6.2, J7.2, J7.17, J8.10, J9.2, JP1.1 (A), Q1.1 (S1), Q7.1 (S), Q7.4 (S), R1.2, R2.2, R8.2, R11.2, R20.2, R21.2, R23.2, R32.1, R34.1, R35.1, R40.1, R41.1, R44.1, R47.1, R61.2, R64.2, R74.2, SW1.1, SW2.1, U1.8 (GND), U1.13 (GND), U1.18 (GND), U1.21 (GND), U3.5 (CSN), U4.27 (GND), U5.3 (AGND), U5.8 (GND), U6.3 (AGND), U6.8 (GND), U7.2 (VSS), U7.5 (DSR), U7.7 (~SR0), U8.2 (VSS), U8.5 (DSR), U8.7 (~SR0), U9.7 (VSS), U9.49 (VSS), U10.2 (GND), Y2.2 (G), Y2.4 (G)
unnamed: C54.2, R68.1, Y1.2
unnamed: C55.1, R69.1, Y1.1
unnamed: C56.2, R70.2, Y2.1
unnamed: C57.1, R71.1, Y2.3
unnamed: D6.2 (A), R29.1
unnamed: D8.4 (DI), Q8.6 (D1), R79.2
unnamed: Q1.5 (G2), R7.2
unnamed: R42.1, R43.2
unnamed: R45.1, R46.2
