flisboac/mixpower-path-mini-bq25672-lv-board/stm32cubemx/STM32G0B1CBU6/STM32G0B1CBU6.ioc

Mcu.UserName=STM32G0B1CEUx
PA0.GPIO_Label=PHER2__GP1__IRQ2__SYS_WKUP2
PA0.Signal=SharedStack_PA0
PA1.GPIO_Label=PHER2__GP2
PA1.Signal=GPIO_Output
PA10.GPIO_Label=USBC__UCPD1_DBCC2
PA10.Signal=UCPD1_DBCC2
PA13.GPIO_Label=MCU__SYS_SWDIO
PA13.Signal=SYS_SWDIO
PA14-BOOT0.GPIO_Label=MCU__SYS_SWCLK__BOOT0
PA14-BOOT0.Signal=SYS_SWCLK
PA15.GPIO_Label=PHER2__RGB_CS
PA15.Signal=GPIO_Analog
PA2.GPIO_Label=IRQB__LPUART1_TX__SYS_WKUP4
PA2.Signal=SharedStack_PA2
PA3.GPIO_Label=IRQB__LPUART1_RX
PA3.Signal=LPUART1_RX
PA4.GPIO_Label=PHER2__GP3__ADC1_IN4__DAC1_OUT1
PA4.Signal=SharedStack_PA4
PA5.GPIO_Label=PHER2__GP4__ADC1_IN5__DAC1_OUT2
PA5.Signal=SharedStack_PA5
PA6.GPIO_Label=PHER1__I2C2_SDA
PA6.Signal=I2C2_SDA
PA7.GPIO_Label=PHER1__I2C2_SCL
PA7.Signal=I2C2_SCL
PA8.GPIO_Label=USBC__UCPD1_CC1
PA8.Signal=UCPD1_CC1
PA9.GPIO_Label=USBC__UCPD1_DBCC1
PA9.Signal=UCPD1_DBCC1
PB0.GPIO_Label=ADC__SNS_3V3_P
PB0.Signal=ADC1_IN8
PB1.GPIO_Label=ADC__SNS_3V3_N
PB1.Signal=ADC1_IN9
PB10.GPIO_Label=ADC__SNS_5V_N
PB10.Signal=ADC1_IN11
PB11.GPIO_Label=ADC__SNS_EN
PB11.Signal=GPIO_Output
PB12.GPIO_Label=USBC__VCC_DIS
PB12.Signal=GPIO_Output
PB13.GPIO_Label=USBC__DISCH
PB13.Signal=GPIO_Input
PB14.GPIO_Label=USBC__UCPD1_FRSTX1
PB14.Signal=UCPD1_FRSTX1
PB15.GPIO_Label=USBC__UCPD1_CC2
PB15.Signal=UCPD1_CC2
PB2.GPIO_Label=ADC__SNS_5V_P
PB2.Signal=ADC1_IN10
PB3.GPIO_Label=PHER2__SPI1_SCK__COMP2_INM
PB3.Signal=SPI1_SCK
PB4.GPIO_Label=PHER2__SPI1_MISO__COMP2_INP
PB4.Signal=SPI1_MISO
PB5.GPIO_Label=PHER2__SPI1_MOSI__COMP2_OUT
PB5.Signal=SPI1_MOSI
PB6.GPIO_Label=USER1__I2C1_SCL__LPUART2_TX
PB6.Signal=SharedStack_PB6
PB7.GPIO_Label=USER1__I2C1_SDA__LPUART2_RX
PB7.Signal=SharedStack_PB7
PB8.GPIO_Label=USER1__BTN0
PB8.Signal=GPIO_Input
PB9.GPIO_Label=PMIC__VDD1_EN
PB9.Signal=GPIO_Analog
PC13.GPIO_Label=PHER1__IRQ1__SYS_WKUP1
PC13.Signal=SharedStack_PC13
PC6.GPIO_Label=USBC__UCPD1_FRSTX2
PC6.Signal=UCPD1_FRSTX2
PC7.GPIO_Label=USBC__FAULT
PC7.Signal=GPIO_Input
PD0.GPIO_Label=PHER2__RGB_EN
PD0.Signal=GPIO_Output
PD1.GPIO_Label=PMIC__BC_CHGEN
PD1.Signal=GPIO_Output
PD2.GPIO_Label=PMIC__SWREG_MODE
PD2.Signal=GPIO_Output
PD3.GPIO_Label=PMIC__5VREG_EN
PD3.Signal=GPIO_Output
PF2-NRST.GPIO_Label=MCU__RESET__NRST
PF2-NRST.Signal=GPXTI2
