flisboac/mixpower-path-mini-bq25672-lv-board/(commit log)

2026-02-23 feat: add production files
    [bom.csv, designators.csv, mixpower-path-mini-axp2585-board-r1.kicad_pcb, positions.csv]
2026-03-16 feat: many changes
    [bom.csv, designators.csv, fuel-gauge.kicad_sch, input-battery.kicad_sch, input-usb.kicad_sch, input-vext.kicad_sch, mixpower-path-mini-axp2585-board-r1.kicad_pcb, mixpower-path-mini-axp2585-board-r1.kicad_sch]
2026-03-17 feat: generate schematic PDF and fix minor schematic mistakes
    [input-usb.kicad_sch, input-vext.kicad_sch, mixpower-path-mini-bq25672-lv-board-r1.kicad_sch]
2026-03-22 feat: small changes in schematics, some PCB routing
    [input-battery.kicad_sch, input-usb.kicad_sch, input-vext.kicad_sch, mixpower-path-mini-bq25672-lv-board-r1.kicad_pcb, output-headers.kicad_sch, power-path.kicad_sch, soc-control.kicad_sch, util-buttons.kicad_sch]
2026-04-27 feat: failed PCB routing
    [input-battery.kicad_sch, input-usb.kicad_sch, input-vext.kicad_sch, mixpower-path-mini-bq25672-lv-board-r1.kicad_pcb, mixpower-path-mini-bq25672-lv-board-r1.kicad_sch, output-headers.kicad_sch, power-path.kicad_sch, soc-control.kicad_sch]
